DKen-DevCat/matrix-rc/docs/plan-phase1a.md

# Phase 1-a 計画（2026-10-25）

Phase 1-a（設計書①）のうち、ソフトの作成とあわせて行った購入先の調査の結果と、注文前に決めてほしいことをまとめる。決まったら Notion の部品表を更新し、このファイルの「決めてほしいこと」に結論を書き込む。

## 決めてほしいこと

| # | 項目 | 選択肢 | 推奨と理由 |
|---|---|---|---|
| 1 | **XIAO ESP32S3 Sense の買い先** | (a) スイッチサイエンスの再入荷を待つ（2,724円＋送料650円）<br>(b) Amazon で今すぐ買う（4,580円。出品ページに技適の記載なし）<br>(c) 秋月の再入荷を待つ（2,660円） | **(a)**。1,206円安く、販売店が技適の表示を保証している。待つ間もパソコン側の作業はシミュレータ（`firmware/sim`）で進められる。(b) にするなら、届いた本体で技適マークを確かめ、なければ Wi-Fi を使わない |
| 2 | **ジャンプ用の高減速モーター** | (a) Hailege N20 6V 15rpm（1,600円。減速比の記載なし、1000:1 前後と推定）<br>(b) Pololu 1000:1 HPCB 6V（7,112円、在庫1） | **(a)**。1-a ではカムが1回転してスイッチが反応するかを見るだけなので、減速比が多少違っても困らない。1-b2 でトルクが足りなければ (b) にする |
| 3 | **車台（タミヤ ユニバーサルプレートがどこも在庫切れ）** | (a) 入荷を待つ（タミヤ公式 396円＋送料510円）<br>(b) 100円ショップのプラ板か MDF 板に穴を開けて代わりにする | **(b)**。机上試作なので形は何でもよく、待つ理由がない |
| 4 | **ジャンプ用の MOSFET とダイオードの置き換え**（AO3400・SS14 は面実装でブレッドボードに挿せない） | (a) IRLU3410PBF と 1N5819（どちらもリード部品、秋月）に置き換える<br>(b) 面実装品を変換基板にはんだ付けする | **(a) で決定（2026-10-27）**。配線もピンも変わらない。3.3V で駆動したときのオン抵抗は未確認だが、流れるのは数百 mA なので足りる見込み。Notion の部品表、W1 システム構成図、W2 配線図を IRLU3410／1N5819 に直した。名刺サイズの C2（1-b3）は面実装の AO3400／SS14 のまま |
| 5 | **電源スイッチの定格**（小型スライドスイッチは 0.5A まで） | (a) 1-a はこのまま使う<br>(b) 定格の大きいスイッチにする | **(a)**。机上ではモーターが止められたときの電流に注意すればよい。名刺サイズにまとめる 1-b3 で見直す |
| 6 | **PlatformIO の導入**（実機へ書き込むのに必要。ネットワークから入れる） | (a) 今入れて、実機用ファームウェアのビルドを確認する<br>(b) XIAO が届いてから入れる | **(a)**。ビルドが通るかを部品が届く前に確かめておける（今は仮のヘッダで文法を確かめただけ） |
| 7 | **1-b1 の LTE 回線をどう用意するか**（技適済み Cat.1 bis モジュール EG800AK-JP・SIM7672JP は、どちらも個人向けの通販が見つからない） | (a) 代理店へ問い合わせて評価ボードかモジュールを入手し、機体に載せる<br>(b) 会場側にモバイルルーターを置き、機体は Wi-Fi のまま<br>(c) 中古スマホを機体に載せる | **(a) で決定（2026-10-25）**。会場のインフラの制約で会場側に機器を置けないため、機体で通信させる。(b) は却下。(c) はスマホだけで 110〜135g と機体目標（約 100g）の 2 倍を超えるので却下。進め方は下の「LTE を機体に載せる進め方」。**最初の行動は メカトラックス MicroCat.1U（SIM7672JP 搭載・技適取得済み・13,500円税別）の購入**。代理店への問い合わせは、MicroCat.1U で足りないと分かったときの保険に格下げ |

以前からの未決事項（Phase 1-a の注文には影響しない）：ジャンプの前進距離の対策（ばね軸の前傾か走行モーターの高速化か。1-b2 で決める）、ジオフェンスを条件付きで止めるか警告だけにするか、ペア運用の操作の形（2人で協力か1人で切り替えか）。

## 配線で気をつけること（調査でわかったもの）

- DRV8833 基板（Kitronik 5108）は nSLEEP 端子を High にしないとモーターが回らない。3.3V につなぐ
- WS2812B モジュールの電源は 3.5〜5.3V。3.3V ではなく電池から取る
- リポの JST コネクタは赤黒の向きがメーカーによって違う。つなぐ前にテスターで赤が＋であることを確かめる

---

## 購入計画（調査結果）

- 調査日: 2026-10-25（価格・在庫はこの日に各店の商品ページで確認したもの）
- 表記: **確認済み** = 商品ページで税込価格と在庫を確認した。**推定** = ページに記載がなく推測した。**未確定** = 在庫切れなどで今は買えない。
- 実際の購入、カート操作、問い合わせはしていない。

### 最初に読むこと（予定どおりに買えない3点）

1. **XIAO ESP32S3 Sense は国内の電子部品店ではどこも売り切れ。** スイッチサイエンス（8969）は「売り切れ・在庫数0」、秋月（118079）は「入荷未定」。今すぐ買えるのは Amazon（4,580円・Amazon 発送）だけで、出品ページには技適の記載がない（後述）。
2. **タミヤのユニバーサルプレートはどこも在庫切れ。** 秋月（109100）は入荷未定、Amazon（タミヤ 70098、販売元 Amazon.co.jp）は一時的な在庫切れ、タミヤ公式ショップは 70098・70157・70172 すべて在庫なし。総額には入れていない。
3. **AO3400 と SS14 は面実装部品で、ブレッドボードに直接挿せない。** また AO3400 は秋月で扱っていない。代わりに、挿して使えるリード部品の IRLU3410PBF（ロジックレベル N-ch）と 1N5819（SS14 と同じ 40V 1A のショットキー）を選んだ。

---

### 店ごとの購入表

#### A. 秋月電子通商（送料: 佐川 550円・ヤマト 600円、税込 11,000円以上は無料）

URL は `https://akizukidenshi.com/catalog/g/g<通販コード>/`

**部品**

| # | 部品 | 商品名 | 通販コード | 数量 | 単価(税込) | 小計 | 在庫 | 確認 |
|---|---|---|---|---|---|---|---|---|
| 5 | N-ch MOSFET（AO3400の代わり） | NchパワーMOSFET 100V17A IRLU3410PBF（リード部品 TO-251） | [106025](https://akizukidenshi.com/catalog/g/g106025/) | 1 | 100 | 100 | 在庫あり(953) | 確認済み |
| 5 | ショットキー（SS14の代わり） | ショットキーバリアダイオード 40V1A 1N5819（10本入） | [117244](https://akizukidenshi.com/catalog/g/g117244/) | 1袋 | 100 | 100 | 在庫あり | 確認済み |
| 5 | 抵抗 100Ω | カーボン抵抗 1/4W 100Ω（100本入） | [125101](https://akizukidenshi.com/catalog/g/g125101/) | 1袋 | 200 | 200 | 在庫あり | 確認済み |
| 5 | 抵抗 100kΩ（3本使う） | カーボン抵抗 1/4W 100kΩ（100本入） | [125104](https://akizukidenshi.com/catalog/g/g125104/) | 1袋 | 200 | 200 | 在庫あり | 確認済み |
| 5 | 抵抗 330Ω | カーボン抵抗 1/4W 330Ω（100本入） | [125331](https://akizukidenshi.com/catalog/g/g125331/) | 1袋 | 200 | 200 | 在庫あり | 確認済み |
| 6 | マイクロスイッチ（レバー付き） | マイクロスイッチ SS-10GL13（オムロン、ヒンジレバー、19.8×6.4mm） | [114659](https://akizukidenshi.com/catalog/g/g114659/) | 1 | 180 | 180 | 在庫あり(319) | 確認済み |
| 7 | WS2812B 1灯モジュール | WS2812B搭載シリアル制御フルカラーLEDモジュール AE-WS2812B | [108414](https://akizukidenshi.com/catalog/g/g108414/) | 1 | 70 | 70 | 在庫あり(263) | 確認済み |
| 10 | 小型スライドスイッチ | 基板用スライドスイッチ SS-12D00-G5（50VDC/0.5A、2.5mmピッチ） | [108790](https://akizukidenshi.com/catalog/g/g108790/) | 1 | 20 | 20 | 在庫あり | 確認済み |
| 11 | 電解コンデンサ 100µF/16V | 電解コンデンサー 100µF16V105℃ ルビコンPX | [110271](https://akizukidenshi.com/catalog/g/g110271/) | 2 | 10 | 20 | 在庫あり | 確認済み |
| 11 | 積層セラミック 0.1µF（3個使う） | 積層セラミックコンデンサー 0.1µF50V X7R 2.54mm（10個入） | [113582](https://akizukidenshi.com/catalog/g/g113582/) | 1袋 | 100 | 100 | 在庫あり | 確認済み |
| 12 | ボールキャスター | ボールキャスター（2セット入り、タミヤ製、高さ11〜35mm） | [110372](https://akizukidenshi.com/catalog/g/g110372/) | 1 | 330 | 330 | **残り5パック** | 確認済み |
| 13 | ブレッドボード | ブレッドボード EIC-801（電源ライン付き、84×54mm） | [100315](https://akizukidenshi.com/catalog/g/g100315/) | 1 | 450 | 450 | 在庫あり | 確認済み |
| 13 | ジャンパーワイヤ オス-オス | ジャンパーワイヤセット（60本以上・長さ混在） | [130088](https://akizukidenshi.com/catalog/g/g130088/) | 1 | 300 | 300 | 在庫あり | 確認済み |
| 13 | ジャンパーワイヤ オス-メス | ジャンパーワイヤ（オス-メス）15cm 青 10本 | [108934](https://akizukidenshi.com/catalog/g/g108934/) | 1 | 220 | 220 | 在庫あり | 確認済み |
| 14 | ピンヘッダー（DRV8833 基板用） | ピンヘッダー 1×40（2.54mm） | [100167](https://akizukidenshi.com/catalog/g/g100167/) | 1 | 35 | 35 | 在庫あり | 確認済み |
| | **部品の小計** | | | | | **2,525** | | |

**道具・消耗品**

| # | 品目 | 商品名 | 通販コード | 数量 | 単価(税込) | 小計 | 在庫 | 確認 |
|---|---|---|---|---|---|---|---|---|
| 14 | 温調はんだごて | 白光 はんだごて FX600-02（温度ダイヤル 200〜500℃） | [114456](https://akizukidenshi.com/catalog/g/g114456/) | 1 | 5,200 | 5,200 | 在庫あり(65) | 確認済み |
| 14 | こて台 | はんだこて台 ST-11（スポンジ付き） | [102537](https://akizukidenshi.com/catalog/g/g102537/) | 1 | 940 | 940 | 在庫あり | 確認済み |
| 14 | はんだ | はんだ 0.8mm（Sn60/Pb40 鉛入り・ヤニ入り） | [118341](https://akizukidenshi.com/catalog/g/g118341/) | 1 | 500 | 500 | 在庫あり | 確認済み |
| 14 | テスター | デジタルマルチメーター MAS-838（導通ブザー付き、10A レンジあり） | [100198](https://akizukidenshi.com/catalog/g/g100198/) | 1 | 2,780 | 2,780 | 在庫あり(18) | 確認済み |
| 14 | データ通信用 USB-C ケーブル | USBケーブル USB2.0 Type-C⇔Type-C 0.5m（通信用） | [117018](https://akizukidenshi.com/catalog/g/g117018/) | 1 | 130 | 130 | 在庫あり | 確認済み |
| 14 | 熱収縮チューブ | スミチューブC クリア Φ3×1m | [108636](https://akizukidenshi.com/catalog/g/g108636/) | 1 | 50 | 50 | 在庫あり | 確認済み |
| 14 | 熱収縮チューブ | スミチューブC 黒 Φ1.5×1m | [106788](https://akizukidenshi.com/catalog/g/g106788/) | 1 | 40 | 40 | 在庫あり | 確認済み |
| 14 | はんだ吸取線 | はんだ吸取線 CP-2015 | [115260](https://akizukidenshi.com/catalog/g/g115260/) | 1 | 210 | 210 | 在庫あり | 確認済み |
| | **道具の小計** | | | | | **9,850** | | |

- **部品だけ買う場合**: 2,525円＋送料 550円（佐川）＝ **3,075円**
- **道具も一緒に買う場合**: 12,375円（11,000円以上なので送料無料）＝ **12,375円**

#### B. スイッチサイエンス（掲載商品はすべて送料区分200: 商品代金 3,000円以上で送料無料、未満は 200円）

URL は `https://www.switch-science.com/products/<SKU>`

| # | 部品 | 商品名 | SKU | 数量 | 単価(税込) | 小計 | 在庫 | 確認 |
|---|---|---|---|---|---|---|---|---|
| 4 | DRV8833 ブレイクアウト | DRV8833搭載モータドライバ基板 10.8V 1.5A（Kitronik 5108、38×28mm） | [8880](https://www.switch-science.com/products/8880) | 1 | 1,298 | 1,298 | **在庫数3** | 確認済み |
| 2 | 走行用ホイール | Pololu ペアホイール 32×7mm 白（3mm D軸用、2個入り） | [1786](https://www.switch-science.com/products/1786) | 1 | 812 | 812 | 在庫25 | 確認済み |
| 12 | N20 取付ブラケット | 超小型メタルギアドモーター用ブラケット（2個入、Pololu 989、10×12mm ギアボックス用、#2 ネジとナット付き） | [9069](https://www.switch-science.com/products/9069) | 2 | 539 | 1,078 | 在庫21 | 確認済み |
| | **小計** | | | | | **3,188** | | |
| | 送料 | 3,000円以上なので無料 | | | | **0** | | 確認済み |

- 第一候補だった [XIAO ESP32S3 Sense（8969）](https://www.switch-science.com/products/8969) は 2,724円（税込）だが**売り切れ（在庫数0、入荷通知の登録のみ可能）**。この商品は送料区分650。
- ブラケットは4個になる（走行用2個＋高減速用1個＋予備1個）。高減速モーターを車体に固定しないなら1袋（539円）でよい。その場合の小計は 2,649円で、3,000円を下回るので送料 200円がかかる。

#### C. Amazon.co.jp（下の5品はすべて「出荷元 Amazon」）

URL は `https://www.amazon.co.jp/dp/<ASIN>`

| # | 部品 | 商品名 | ASIN | 数量 | 価格(税込) | 販売元 | 在庫・お届け予定 | 確認 |
|---|---|---|---|---|---|---|---|---|
| 1 | XIAO ESP32S3 Sense | Seeed Studio XIAO ESP32S3 センス（**ピンヘッダーはんだ付け済み版**） | [B0DRNW6KMG](https://www.amazon.co.jp/dp/B0DRNW6KMG) | 1 | 4,580 | Leverage- | 在庫あり | 確認済み（技適の記載はページにない） |
| 2 | N20 6V 300rpm ×2 | CHANCS N20 DC 6V 300RPM（2個入り、3mm D軸・軸長10mm） | [B0CD1T22QG](https://www.amazon.co.jp/dp/B0CD1T22QG) | 1 | 2,199 | chancs | 残り4点・10/27 着 | 確認済み |
| 3 | N20 高減速 | Hailege N20 6V 15RPM（2個入り、3mm×10mm 軸） | [B0DMW1ZFB3](https://www.amazon.co.jp/dp/B0DMW1ZFB3) | 1 | 1,600 | Hailege JP | 残り20点・10/27 着 | 価格は確認済み。**減速比はページになく、1:1000前後と推定** |
| 9 | 1S リポ 保護回路付き JST-PH | EEMB LP603449-PCM 3.7V 1100mAh（PCM 内蔵、JST-PHR-02 2mmピッチ、34.5×51×6.3mm） | [B08FD39Y5R](https://www.amazon.co.jp/dp/B08FD39Y5R) | 1 | 999 | A2Battery（メーカー直販） | 在庫あり・10/27 着 | 確認済み |
| 8 | JST-PH 2ピン ピグテール | MKBKLLJY JST-PH 2.0 オス・メス ケーブル 15ペア（22AWG 100mm、熱収縮チューブ付き） | [B0CX12NJV9](https://www.amazon.co.jp/dp/B0CX12NJV9) | 1 | 679 | MKBKLLJY | 在庫あり・10/27 着 | 確認済み |
| | **小計** | | | | **10,057** | | | |
| | 送料 | 各ページの表示は「無料配送」 | | | **0** | | | 「初回注文特典」で無料と出ている商品がある。Amazon 発送品は合計 3,500円以上なら通常も無料のはずだが、これは**推定** |

- リポを2本にする場合は +999円。
- XIAO のピンヘッダー**はんだ付けなし版**は [B0C69FFVHH](https://www.amazon.co.jp/dp/B0C69FFVHH)。同じ 4,580円で、販売元も同じ Leverage-（確認済み）。

---

### 合計

| | 秋月 | スイッチサイエンス | Amazon | **合計** |
|---|---|---|---|---|
| **部品のみ**（送料込み） | 2,525＋送料550 ＝ 3,075 | 3,188＋送料0 ＝ 3,188 | 10,057＋送料0 ＝ 10,057 | **16,320円** |
| **部品＋道具**（送料込み） | 12,375＋送料0 ＝ 12,375 | 3,188 | 10,057 | **25,620円** |

- ユニバーサルプレートは在庫がないため含めていない。入荷すればタミヤ公式で 396円（＋送料 510円、5,000円以上は無料）。
- 秋月の部品を佐川ではなくヤマトで送る場合、部品のみの合計は +50円。

#### 選び方で合計が変わるところ

| 変更 | 合計への影響 |
|---|---|
| 高減速モーターを **Pololu 1000:1 HPCB 6V**（スイッチサイエンス [6255](https://www.switch-science.com/products/6255)、7,112円、**在庫1**、減速比が明記されている）にする | +5,512円（Hailege の 1,600円が不要になる） |
| XIAO をスイッチサイエンスの再入荷を待って買う（2,724円＋区分650の送料 650円。小計が 8,000円未満のため） | Amazon 経由より **-1,206円**。技適の表示も販売店が保証している |
| XIAO をカメラなしの **XIAO ESP32S3**（秋月 [118078](https://akizukidenshi.com/catalog/g/g118078/) 1,480円・在庫あり／スイッチサイエンス [8968](https://www.switch-science.com/products/8968) 1,456円・在庫あり）にして、カメラは後で考える | 秋月で買う場合は -3,100円。ただしカメラとマイクがなくなる |
| 走行用ホイールを **FEETECH Dシャフト用ホイール 60mm**（スイッチサイエンス [7494](https://www.switch-science.com/products/7494)、1個110円、在庫4）×2 にする | -592円。直径が大きいので速くなり、キャスターの高さも変わる |

#### 店ごとの代わりの候補（すべて確認済み）

- MOSFET を面実装で揃えたい場合: 秋月 MTN2306AN3（[117513](https://akizukidenshi.com/catalog/g/g117513/)、10個 120円）＋ SOT23変換基板（[103659](https://akizukidenshi.com/catalog/g/g103659/)、30円）。変換基板へのはんだ付けが必要。
- SS14 そのものが欲しい場合: 秋月 [113240](https://akizukidenshi.com/catalog/g/g113240/)（20個 150円、面実装）。
- 純正 JST の PH ポスト: 秋月 B2B-PH-K-S（[112802](https://akizukidenshi.com/catalog/g/g112802/)、10円）。電池の PHR-02 と確実に嵌合する。
- DRV8833 の代わりに秋月だけで済ませる場合: DRV8835使用DCモータードライブキット（[110346](https://akizukidenshi.com/catalog/g/g110346/)、600円、在庫あり）。自分ではんだ付けするキット。

---

### 技適（無線部品）

- **XIAO ESP32S3／ESP32S3 Sense**: 工事設計認証番号 **217-230892**（秋月の商品ページの記載）。スイッチサイエンスのページには「技適マークの表示された製品です。商品写真は古いロットでマークがないが、現物には表示されている」とある。
- **Amazon で買う場合**: 出品ページに技適の記載はない。Seeed の正規品なら同じ認証の対象と考えられるが、これは**推定**。届いたら本体のシールドかラベルで技適マークを確認し、マークがなければ電波を出さない（Wi-Fi/BLE を使わない）こと。確実にしたいなら、スイッチサイエンスか秋月の再入荷を待つ。
- ほかの部品に送信機能を持つものはない。

---

### 初心者が迷いやすい点

**XIAO ESP32S3 Sense**
- スイッチサイエンス版と Amazon B0C69FFVHH には 7ピンのヘッダーが2本付いてくるが、はんだ付けはされていない。ブレッドボードに挿すには自分ではんだ付けする。Amazon B0DRNW6KMG ははんだ付け済み。
- XIAO に電池用のコネクタはない。裏面の **BAT+／BAT− パッド**に線をはんだ付けし、その先にピグテールを付ける。
- USB-C からの充電電流は 100mA（スイッチサイエンスの仕様）。1100mAh の電池だと満充電まで約11時間以上かかる（推定）。
- XIAO の BAT 入力は 4.2V（仕様）。1S リポ以外はつながない。

**リポ電池と極性**
- JST-PH の赤黒の向きは、メーカー間で統一されていない。EEMB のページにも「使用前に機器とコネクタの極性を確認」とある。はんだ付けや接続の前に、必ずテスターで電池の赤＝＋を確かめ、XIAO の BAT+ へ赤がつながることを確認する。逆に挿すとショートや故障につながる。
- 電池側のコネクタは **PHR-02（ハウジング側）**。秋月の「コネクター付コード 2P(A)」（105679）やスイッチサイエンス 2215 も同じハウジング側なので、**電池とは嵌合しない**。電池と嵌合するのは、Amazon セットの「オス」側か、秋月 B2B-PH-K-S（ポスト）。
- Amazon の互換品「オス」は純正 JST ではない。固い・緩いことがある。
- EEMB のページには保護回路（PCM）、UL1642、IEC62133-2 の記載があるが、**PSE の記載はない**。保管と充電は耐火のリポバッグなどで行うのが安全。

**N20 モーター**
- **「1000RPM」と「1000:1」は別物。** Amazon には「1000RPM（毎分回転数）」と書かれた高速モーターが多い。今回の高減速は「低 rpm（6V で 15〜30rpm 程度）」を選ぶ。走行用の 300rpm と取り違えないよう、届いたらラベルで確認する。
- Hailege 6V 15RPM のページには減速比が書かれていない。別の出品の仕様表（6V 300RPM＝1:50）から逆算して 1:1000 前後と推定した。比率を保証したいなら Pololu 1000:1（6255）を選ぶ。
- 6V 定格のモーターを 1S（3.7〜4.2V）で回すので、無負荷回転は表示の6〜7割程度になる（推定。300rpm 品なら約180〜210rpm）。机上試験には十分。
- **走行用は 1-a では 300rpm のままでよい。** 2026-10-28 の物理演算で、真上に跳んで 3cm の段差を越えるには走行 0.5m/s 以上が要ると分かった（設計書② 7章・C4）。上の「1000RPM と 1000:1 は別物」の注意は、ジャンプ用（高減速）を買うときの話。
- **1-b の走行モーターは Pololu 136:1 Sub-Micro 遊星ギアモーター 6Dx19L（#2358）×2**（2026-10-29 決定。N20 1000rpm 級から変更）。長さ 19mm なので左右を一直線に並べられ、後輪を揃えられる（N20 は 24mm で並ばず、前後にずらすと段差越えのあと向きが変わる）。1-b2 の段差試験までに買う。注意：
  - 軸は 2mm の D カット。いま買った Pololu 32×7mm の車輪は 3mm 用なので、2mm→3mm のアダプタか、2mm 軸に合う車輪が要る
  - ギアは樹脂。段差で車輪が止められたときに歯が欠けないか、1-a の机上で先に 1 個試す
  - 6V 定格を 1S で回すので、ファームは速度の上限を 1.0 にした設定（`pio run -e xiao_1b`）で書き込む
- 軸は 3mm の D カット、長さ10mm。Pololu 32×7mm ホイールと FEETECH ホイールはどちらも 3mm D 軸用で適合する。
- Pololu 989 ブラケットは 10×12mm のギアボックス部を挟む形。汎用の N20 も同じ断面なので取り付けられる。ただし減速比でギアボックスの長さが変わるので、挟む位置を合わせる。
- 汎用の N20 は端子がむき出しのものが多い。リード線をはんだ付けし、モーター端子間に 0.1µF を付けるとノイズ対策になる。

**DRV8833（Kitronik 5108）**
- 同梱品は基板1枚だけで、ピンヘッダーは付いていない（販売店ページの同梱内容から判断）。秋月のピンヘッダーを切ってはんだ付けする。
- 38×28mm と大きいので、ミニブレッドボードではなく EIC-801 にした。
- **nSLEEP 端子を High にしないとモーターが動かない**（DRV8833 の nSLEEP は内部でプルダウンされている）。GPIO で制御するか 3.3V につなぐ。
- 電源 Vcc は 2.7〜10.8V（仕様）なので、1S リポを直接つなげる。在庫が3個しかない点にも注意。

**MOSFET とダイオード（高減速モーターのローサイドスイッチ）**
- IRLU3410PBF は「IRL」系のロジックレベル品で、ピンのピッチは 2.29mm（秋月の仕様）。ブレッドボードには少しピンを広げて挿す。3.3V 駆動時のオン抵抗はデータシートで確認すること（ここでは確認していない）。
- 1N5819 はモーターと逆向き（並列）に入れるフライバックダイオード。帯のある側をモーターの＋側（電源側）に向ける。

**スライドスイッチ**
- 小型スライドスイッチは定格 0.5A が上限（SS-12D00-G5）。電池の主電源をこれで切り替えると、モーター2個の起動電流やロック時の電流には余裕がない。机上試作では問題になりにくいが、本番では定格の大きいスイッチを使うか、XIAO の電源だけを切るなど構成を見直すこと。

**WS2812B**
- 秋月のモジュールは電源電圧 3.5〜5.3V（仕様）。**3.3V ではなく電池（3.7〜4.2V）から給電**する。データ線には 330Ω を直列に入れる。

**その他**
- マイクロスイッチ SS-10GL13 の端子はラグ形で、ブレッドボードには挿せない。リード線をはんだ付けする。
- タミヤのボールキャスターは高さを 11〜35mm で調整できる。32mm ホイールなら車軸の高さは約16mm なので、組み立て後に車体が水平になる高さに合わせる。
- はんだは初心者が扱いやすい鉛入り（Sn60/Pb40）にした。換気し、作業後は手を洗う。鉛フリーにするなら秋月 [129524](https://akizukidenshi.com/catalog/g/g129524/)（520円）。
- USB-C ケーブルは Mac につなぐ前提で C-C にした。USB-A ポートにつなぐなら秋月 [117017](https://akizukidenshi.com/catalog/g/g117017/)（A-C 0.5m、100円）。
- ニッパーとワイヤーストリッパーは対象外として計上していない。持っていなければ別途必要。
- ユニバーサルプレートの代わりは、入荷を待つか、100円ショップのプラ板や MDF 板に穴を開けて使う。

---

### 参考: 部品表 B の LTE Cat.1 bis 評価ボード

| 候補 | 調査結果 | 結論 |
|---|---|---|
| Quectel EG800AK-JP | Quectel が 2026年4月のプレスリリースで技適（TELEC）取得を発表（[Quectel](https://www.quectel.com/news-and-pr/telec-certified-cat-1-bis-module-japan-it-week-spring-2026/)）。[SoftBank の IoT カタログ](https://www.softbank.jp/business/service/iot/module/pdf/cidna-eg800ak-jp-catalog.pdf)にも掲載がある。個人が通販で買える評価ボードは、スイッチサイエンス、秋月、検索結果のどこにも見つからなかった | **代理店への問い合わせが必要** |
| SIMCom SIM7672JP | [NTT](https://www.ntt.com/business/iot/product/m284.html) と [SoftBank](https://www.softbank.jp/business/service/iot/module/pdf/cidna-sim7672jp-catalog.pdf) の法人 IoT ページにモジュールの IOT 完了の記載がある。見つかった評価キットは欧州向けの SIM7672E/G 用だけで、JP 版の個人向け販売は見つからなかった | モジュール単体は代理店。**ただし下の MicroCat.1U に載っている** |
| **メカトラックス MicroCat.1U**（SIM7672JP 搭載） | [製品ページ](https://mechatrax.com/products/microcat1/)、[1U の発売案内](https://mechatrax.com/2026/08/04/microcat1u-release/)、[公式ストア](https://store.mechatrax.com/)。RP2350B＋SIM7672JP、U.FL＋技適取得済みアンテナ付属、13,500円（税別）、個人購入可 | **1-b1 はこれで進める**（決めてほしいこと 7） |

- 方針どおり、LILYGO SIM7672G/SIM7670G は技適がないため候補にしていない。
- スイッチサイエンスで個人が買える技適済み LTE 製品には Cat-M や Wio LTE などがあるが、Cat.1 bis ではないので対象外。Cat-M（LTE-M）は上りが数百 kbps で、QVGA の MJPEG（9fps で 400〜700kbps）には足りない。

#### 入手先の候補（2026-10-25 に検索で確認。購入前に各ページで再確認する）

「個人が買える技適済みの Cat.1 bis」は、検索で確認できた範囲では **メカトラックスの MicroCat.1／1U だけ**だった。Google の AI 回答が挙げた他の経路は、確認すると条件が付く。

| 候補 | 中身 | 技適 | 個人購入 | 判定 |
|---|---|---|---|---|
| **メカトラックス MicroCat.1U** | RP2350B（Raspberry Pi Pico 2 互換ピン）＋ **SIM7672JP**（部品表 B と同じモジュール）。U.FL コネクタと技適取得済みの 4G アンテナが付属。nanoSIM。2026-08-04 発売、13,500円（税別） | 基板として JATE/TELEC 取得済み（公式の記載） | 公式ストアで可 | **本命**。1-b1 はこれで始める |
| メカトラックス MicroCat.1 | 上と同じでアンテナが基板上。2026-06-30 発売、13,500円（税別） | 同上 | 可 | アンテナを筐体内で動かせないので 1U を選ぶ |
| LILYGO T-SIM7670G-S3／TUOPUONE ESP32-S3 SIM7670G | ESP32-S3＋SIM7670G（海外版 Cat.1 bis）。6,000〜8,000円 | **モジュールの設計**には工事設計認証 201-230743（SIMCom、2025-08-13、MRA 経由）がある。ただし Amazon／AliExpress で買う個々の基板のモジュールに**技適マークが表示されているか**、付属アンテナが認証条件に合うかは確認できない。LILYGO が認証書を公開している機種にこの型が含まれるかも未確認 | 可 | **使わない**（CLAUDE.md の方針どおり。マークの表示と認証条件のアンテナを販売元が証明できれば再検討） |
| Quectel EG800AK-JP／EG915Q-JP（Mouser・DigiKey） | 生モジュールか評価ボード | モジュールに JATE/TELEC | DigiKey で見つかるのは **北米・欧州版（-NA／-EU）だけ**で、-JP の在庫は確認できなかった | 入手経路として当てにしない |
| Quectel EG915Q-JP 評価キット（加賀デバイス） | UMTS&LTE EVB KIT JP／mini PCIe EVB KIT JP。国内適合アンテナ付き | モジュールに JATE/TELEC、docomo／KDDI の IOT 完了 | 見積り（個人可否・価格は不明） | 保険。MicroCat.1U で足りないとき |
| SIMCom SIM7672JP 評価ボード（キャセイ・トライテック／ザイン・モバイルテック） | 評価ボード | JATE/TELEC、docomo IOT 完了 | 見積り。SIM7672JP 用 EVB の型番は公開ページに見つからない | 保険 |

**MicroCat.1U を選ぶ理由**：(1) 設計書②で選んでいた SIM7672JP そのもの（B1/B3/B8/B18/B19/B26/B28、上り 5Mbps）。(2) 基板単位で技適が取れていて、アンテナも認証条件のものが付属するので、1-b3 で「自作基板＋アンテナ設計」をしなくてよくなる可能性が高い。(3) Pico 2 互換なら基板は 21×51mm 級（寸法は未確認）で、名刺サイズの下段に XIAO と並べて置ける見込み。

**MicroCat.1U で確認すること（買う前にメカトラックスへ聞くか、資料で見る）**

- SIM7672JP の UART が Pico 互換ヘッダに直接出ているか。出ていなければ RP2350B に「UART の素通し」ファームを入れて XIAO の D6/D7 とつなぐ（MicroPython で数十行）
- 電源：1S リポ（3.4〜4.2V）を VSYS に入れて SIM7672JP まで動くか。送信バースト時の電流と、基板上に入っているコンデンサ
- 基板の寸法・重さ、SIM7672JP の UART の最大速度（PPP の帯域上限になる）
- 技適マークの表示場所（基板のシール）

#### LTE を機体に載せる進め方（決めてほしいこと 7 の決定を受けて）

難しさは段階で分かれる。1-b1 は「ソフトが主で、手を動かす部分は配線だけ」。1-b3 は、MicroCat.1U がそのまま載るなら「配置と筐体」、載らないなら「基板を作ってはんだ付けする」で、後者が本当の山。どちらも AI が肩代わりできる部分と、できない部分をはっきり分けておく。

| 段階 | やること | 難しさ | AI が肩代わりできる | 自分で手を動かす |
|---|---|---|---|---|
| 入手 | メカトラックス公式ストアで MicroCat.1U を 1 枚買う（上の表）。代理店への問い合わせは保険 | **低**（見つかった） | 購入前の確認事項の整理、資料（SIM7672 の AT コマンド集・メカトラックスの資料）の読み込み | 購入・SIM の契約 |
| 1-b1 | MicroCat.1U を 1-b1 用の大きめの台車に載せ、XIAO の D6/D7（UART）でつなぐ（必要なら RP2350B を UART の素通しにする）。機体→VPS の UDP と DTLS-PSK を通す | **中**。配線は UART 2 本＋電源＋GND。ファームウェアが作業の大半 | ファームウェア全部（下の「ファームウェアの作り方」）、RP2350B の素通しファーム、電源の計算、AT コマンドの手順、ログの読み解き | 配線、SIM の挿入、電波の実測（床置きで RSSI／到達率） |
| 1-b3 | MicroCat.1U をそのまま名刺サイズの下段に収める。収まらないか電源が足りないときだけ、SIM7672JP（LCC＋LGA、17.6×15.7mm）を載せる小基板を自作する | そのまま載るなら **中**（配置・筐体・放熱）。自作基板なら **高**（下の 4 点） | KiCad の回路図・部品配置・配線の作成とチェック、設計ガイドとの照合、BOM、ステンシル付きの基板発注データ | 配置と筐体の工作。自作基板ならはんだ付け（ホットプレートかホットエアでのリフロー）、テスターでの確認、2〜3 回の基板の作り直し |

**「初めてのハード開発には重い」の中身**は、自作基板に進んだ場合の次の 4 点。いずれも「できない」ではなく「回数とお金がかかる」種類の難しさで、MicroCat.1U がそのまま載れば 1 と 3 はなくなる。

1. **実装**：モジュールは LCC（側面の端子）＋LGA（裏面の端子）で、手はんだでは裏面に届かない。ホットプレート（数千円）とステンシル（基板と一緒に発注、数百円）でリフローする。ホビーでは一般的な手順で、失敗しても部品代（モジュール 1 個数千円）で済む。モジュールは最初から 2 個買う
2. **電源**：送信時に 1〜2A のバーストが出る。XIAO の 3.3V からは取れないので、電池（3.4〜4.3V）からモジュールへ直結し、すぐそばに 100µF 以上を置く。電池が 3.5V を切ると送信のたびにモジュールが落ちる（設計書①の警告 3.5V はこのためにも効く）
3. **アンテナ**：基板上にアンテナを設計せず、モジュールのアンテナ端子から短い 50Ω の線で u.FL コネクタへ出し、技適の認証条件（利得の上限）に合う FPC アンテナを買って貼る。これで基板側の高周波設計をほぼなくせる。91mm の筐体でグランドが足りず効率が落ちる問題（レビュー A-5）は残るので、1-b1 の評価ボードで床置きの実測をしてから筐体内の置き場所を決める
4. **技適の守り方**：工事設計認証はモジュール単体に付く。モジュールを改造せず、認証条件の範囲のアンテナを使えば、自作基板に載せても問題ない。設計ガイドに書かれた条件（アンテナ利得・電源）から外れない

**ファームウェアの作り方（1-b1）**：モジュールの中の TCP/UDP を AT コマンドで操る方式ではなく、**PPP でつなぐ**。ESP-IDF の `esp_modem` が Quectel／SIMCom 系の AT 手順と PPP を持っていて、つながった後は Wi-Fi のときと同じ UDP ソケットと mbedTLS の DTLS がそのまま使える。`lib/core`（判断ロジック）はハードに依存しないのでそのまま。変わるのは「Wi-Fi の接続」が「モジュールの起動＋PPP」になる部分だけ。Arduino のまま進めるなら Arduino を ESP-IDF のコンポーネントとして組む形になるので、1-b1 では ESP-IDF に寄せるのが素直。

**帯域の現実**：UART の速さが上限になる。921,600bps なら PPP の後で実効 700kbps 程度。いまの機体は映像（QVGA 9fps で 400〜700kbps）＋音声（16kHz 16bit PCM で 256kbps）なので、音声は 8kHz か圧縮に、映像は 5fps 程度に落とす。モジュールが 2〜3Mbps の UART に対応していれば上げる。USB で結ぶ道（ESP-IDF の `esp_modem_usb_dte`）もあるが、XIAO の USB は書き込みにも使うので後回し。

**代理店に聞くこと**（MicroCat.1U で足りないときの保険。問い合わせの下書きに使う）

- 個人（または個人事業）への販売の可否と、最小数量
- EG800AK-JP／SIM7672JP の評価ボード（EVB キット）の型番・価格・納期。モジュール単体の価格・納期
- ハードウェア設計ガイド、AT コマンド集、工事設計認証の条件（対応アンテナと利得の上限）の入手方法
- UART の最大速度と、PPP での利用可否
- 国内キャリア（docomo／KDDI／SoftBank の MVNO データ SIM）での接続実績。IMEI 登録などの手続きが要るか
- 推奨するアンテナ（FPC タイプ）の型番

**SIM**：国内 MVNO のデータ専用 SIM（docomo 網のものが帯域の相性で無難。SIM7672JP は docomo の相互接続性試験が完了している）。基板が届く前に契約しない。

**1-b1 の完成条件に足すこと**：床置きでの RSSI と到達率、300ms 停止の回数、UART の速さごとの映像 fps。これが 1-b3 の筐体とアンテナの配置を決める材料になる。

---

### 確認元

- 秋月の送料: [ご利用ガイド](https://akizukidenshi.com/catalog/pages/buy.aspx)（佐川 550円／ヤマト 600円、税込 11,000円以上は無料）
- スイッチサイエンスの送料: [配送と送料](https://www.switch-science.com/policies/shipping-policy)（区分200: 3,000円以上無料／未満 200円。区分650: 8,000円以上無料／未満 650円）
- タミヤ公式の在庫: [70098](https://tamiyashop.jp/shop/g/g70098/)、[70157](https://tamiyashop.jp/shop/g/g70157/)、[70144](https://tamiyashop.jp/shop/g/g70144/)（いずれも在庫なし）
- 各商品の URL は表中のとおり。
