DKen-DevCat/matrix-rc/docs/drawings/c1.png

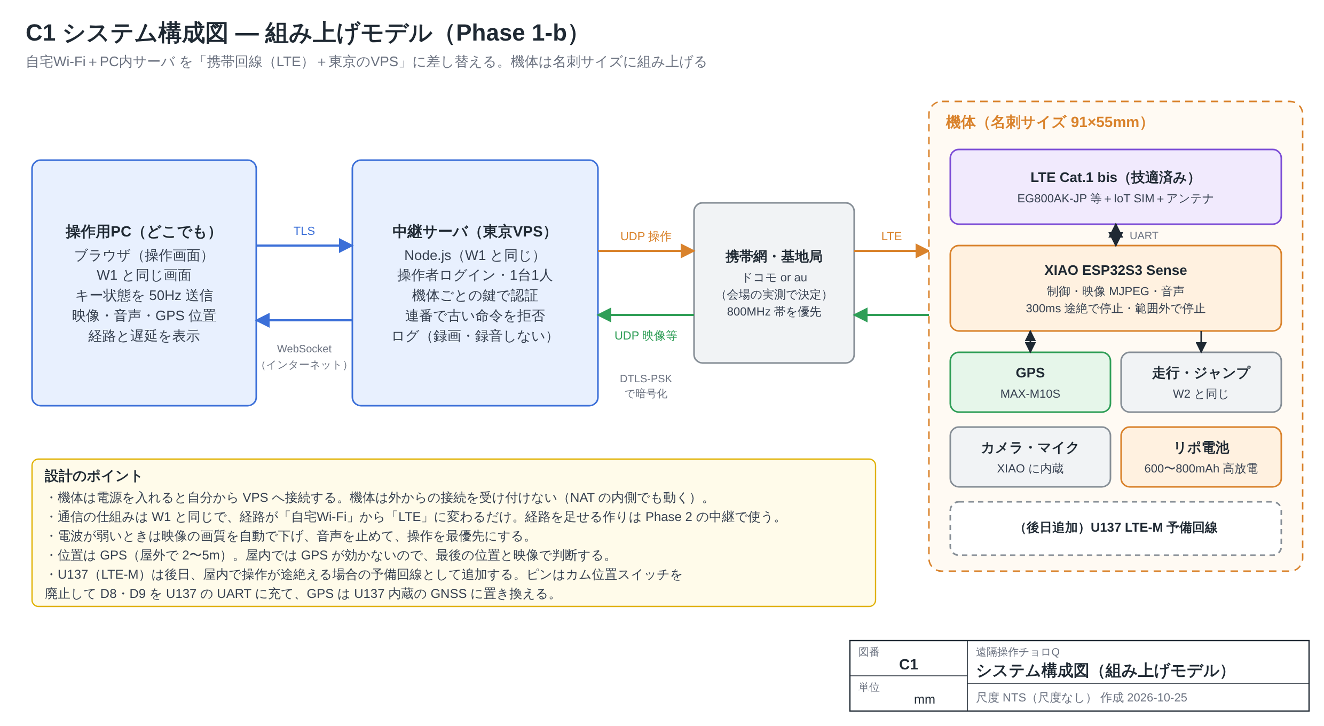
docs/drawings/c1.png
