DKen-DevCat/matrix-rc/docs/drawings/c2.png

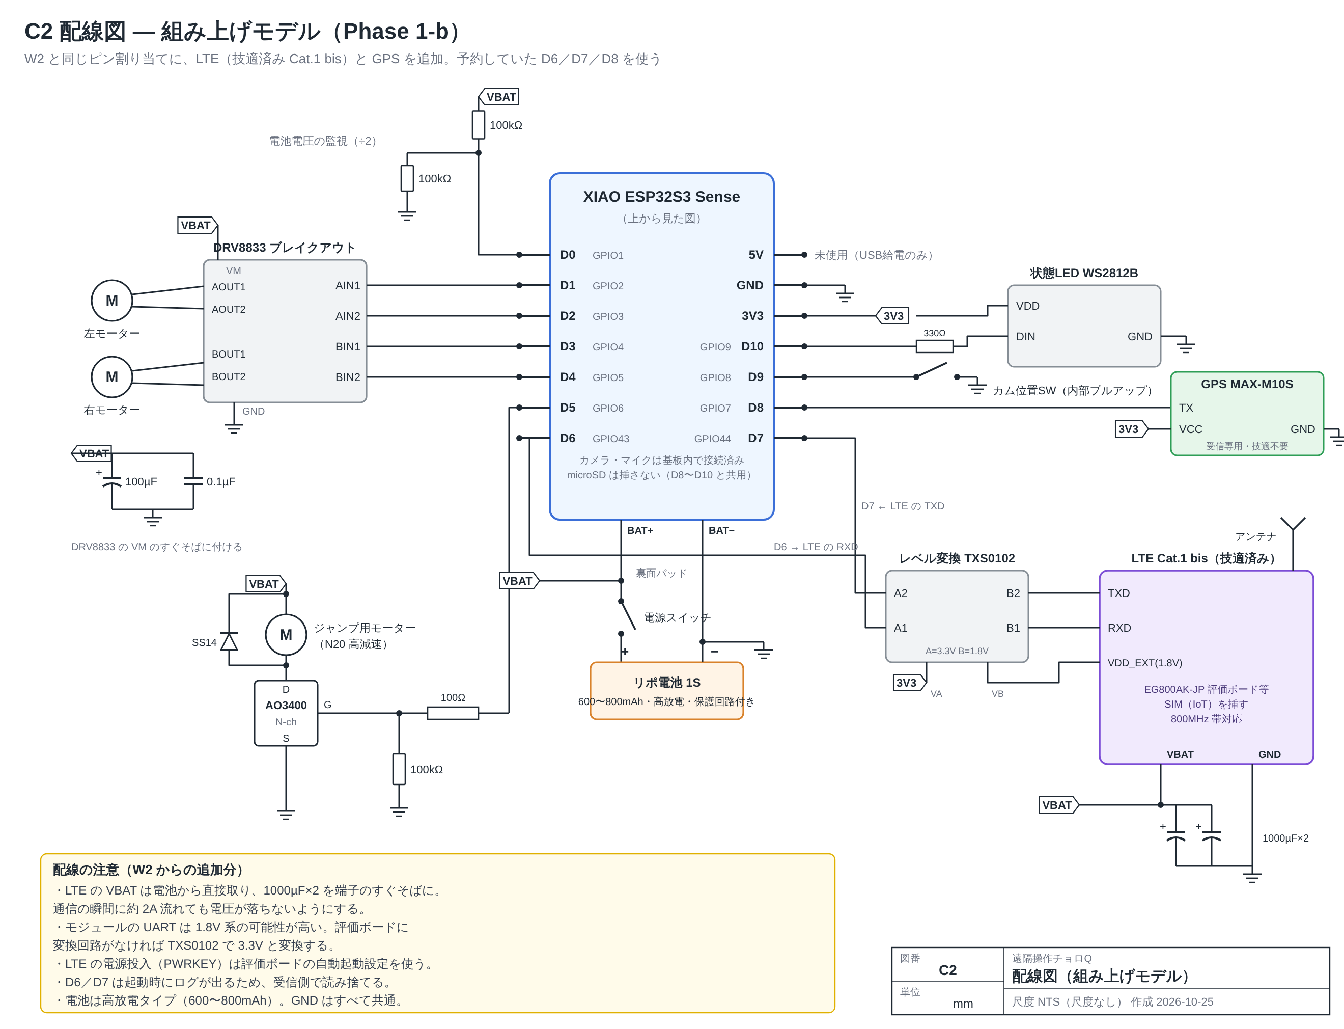
docs/drawings/c2.png
