DKen-DevCat/matrix-rc/docs/drawings/c3.png

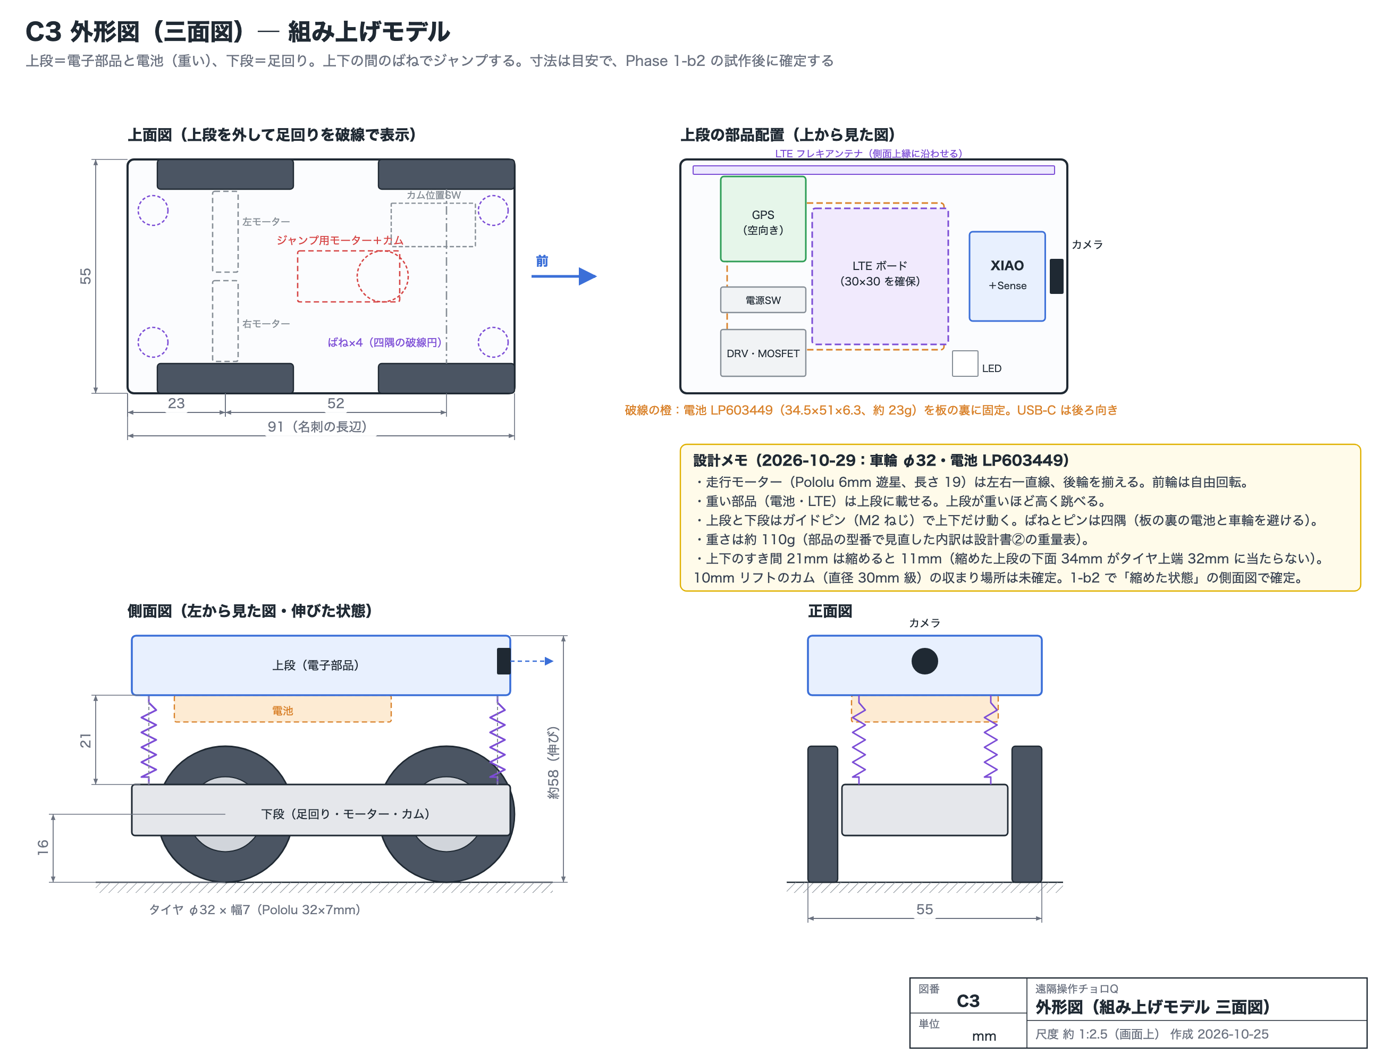
docs/drawings/c3.png
