DKen-DevCat/matrix-rc/docs/drawings/c4.png

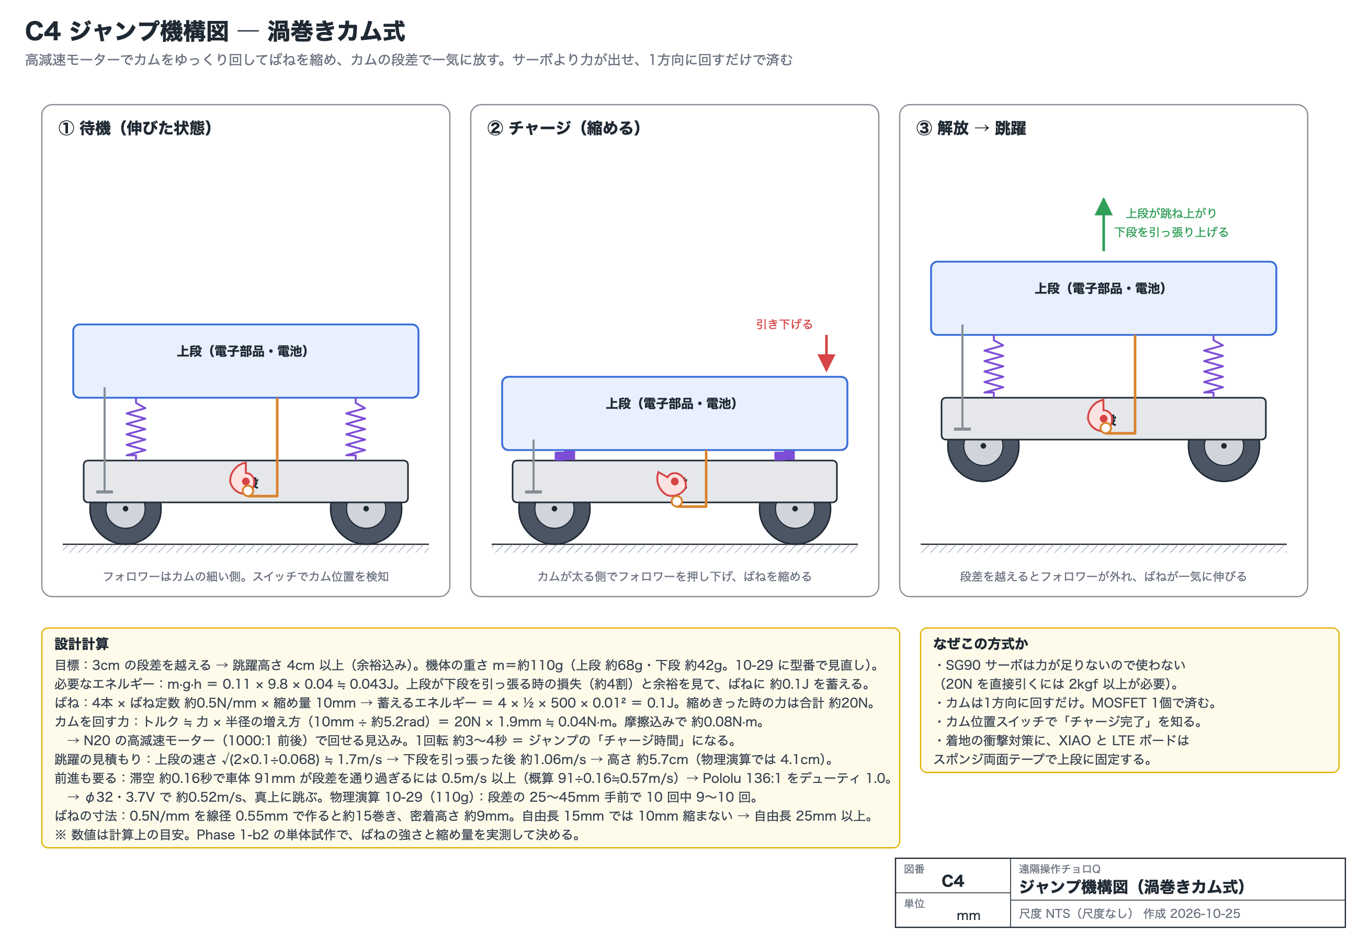
docs/drawings/c4.png
