DKen-DevCat/matrix-rc/docs/drawings/r1.png

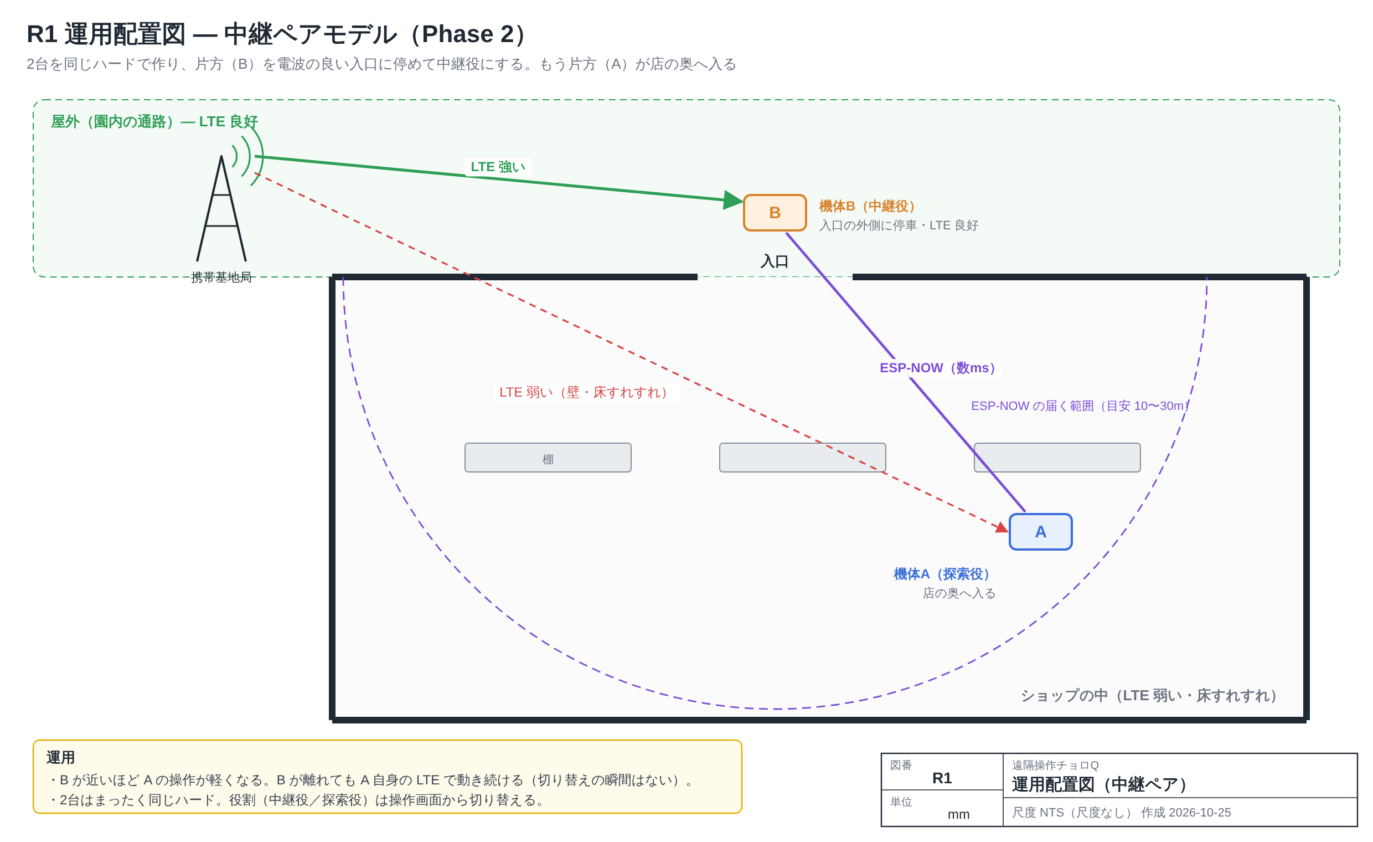
docs/drawings/r1.png
