DKen-DevCat/matrix-rc/docs/drawings/r2.png

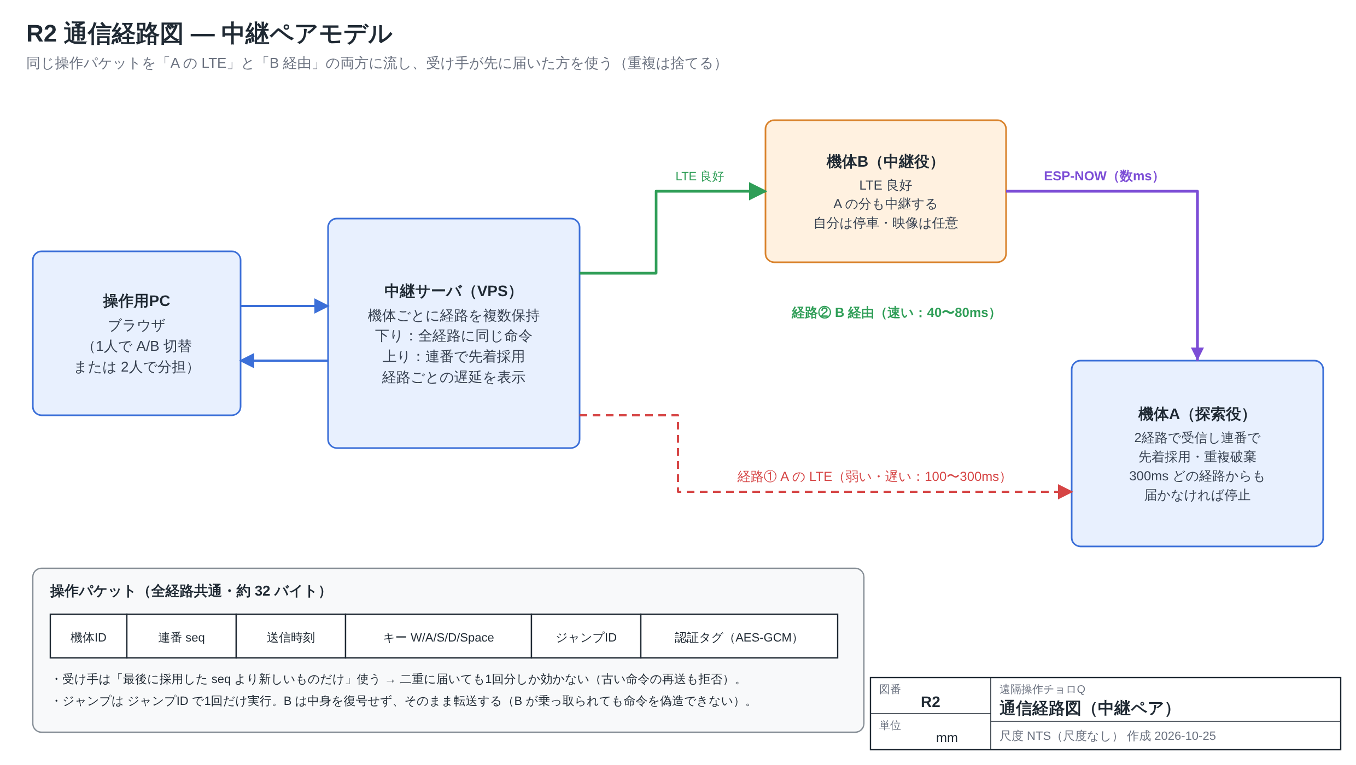
docs/drawings/r2.png
