DKen-DevCat/matrix-rc/docs/drawings/r3.png

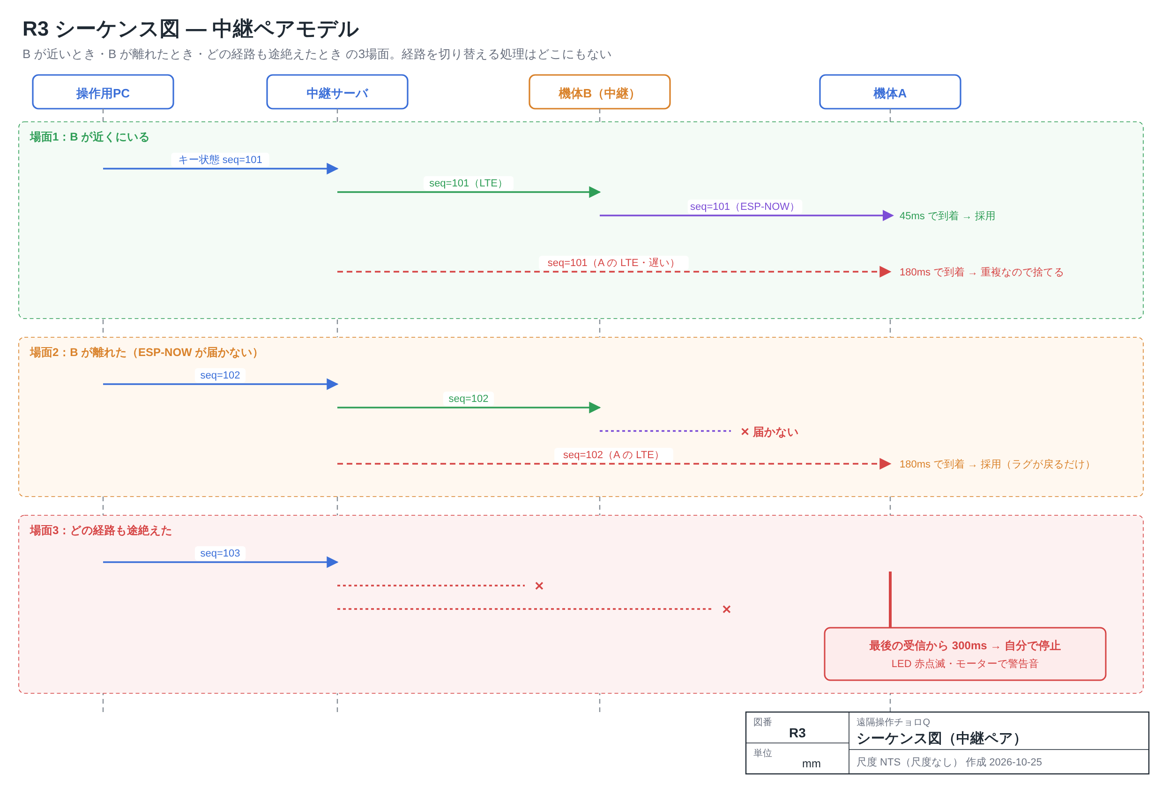
docs/drawings/r3.png
