DKen-DevCat/matrix-rc/docs/drawings/w1.png

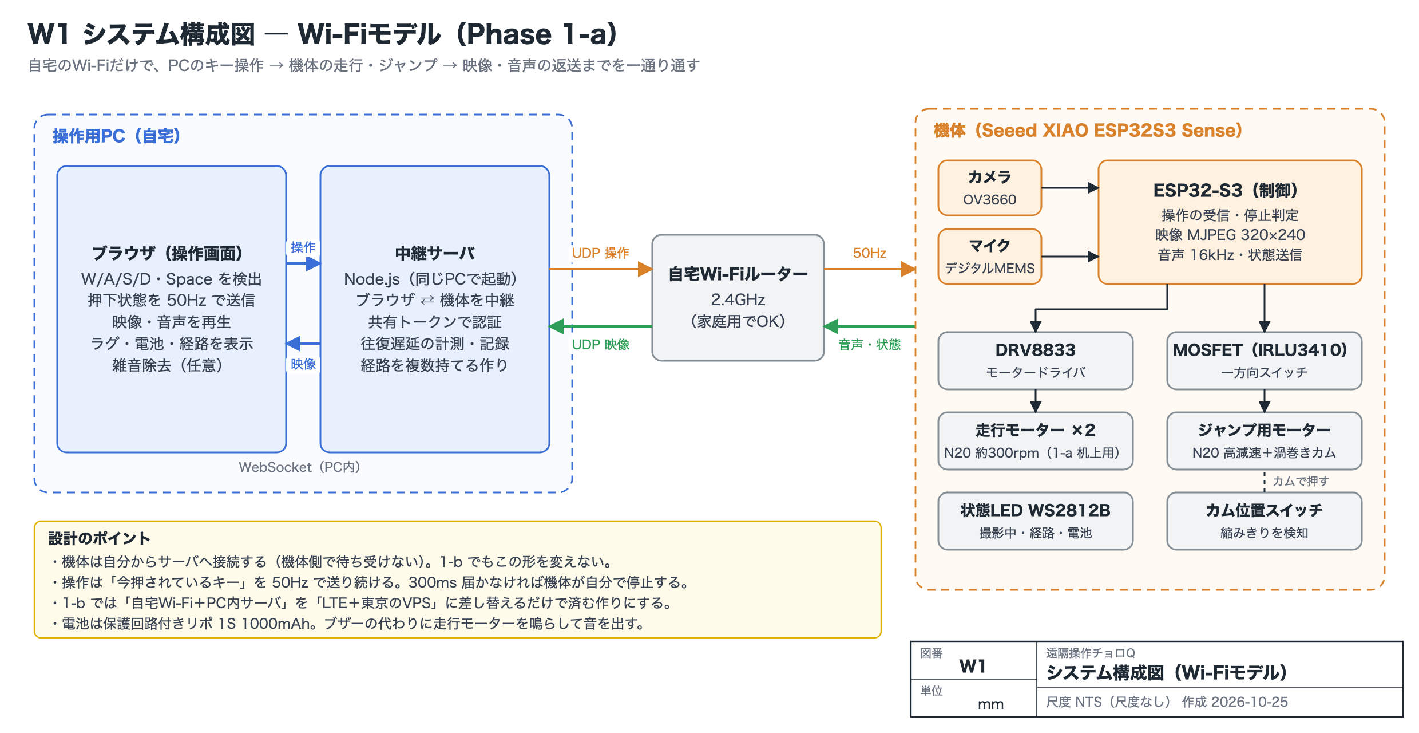
docs/drawings/w1.png
