DKen-DevCat/matrix-rc/docs/drawings/w2.png

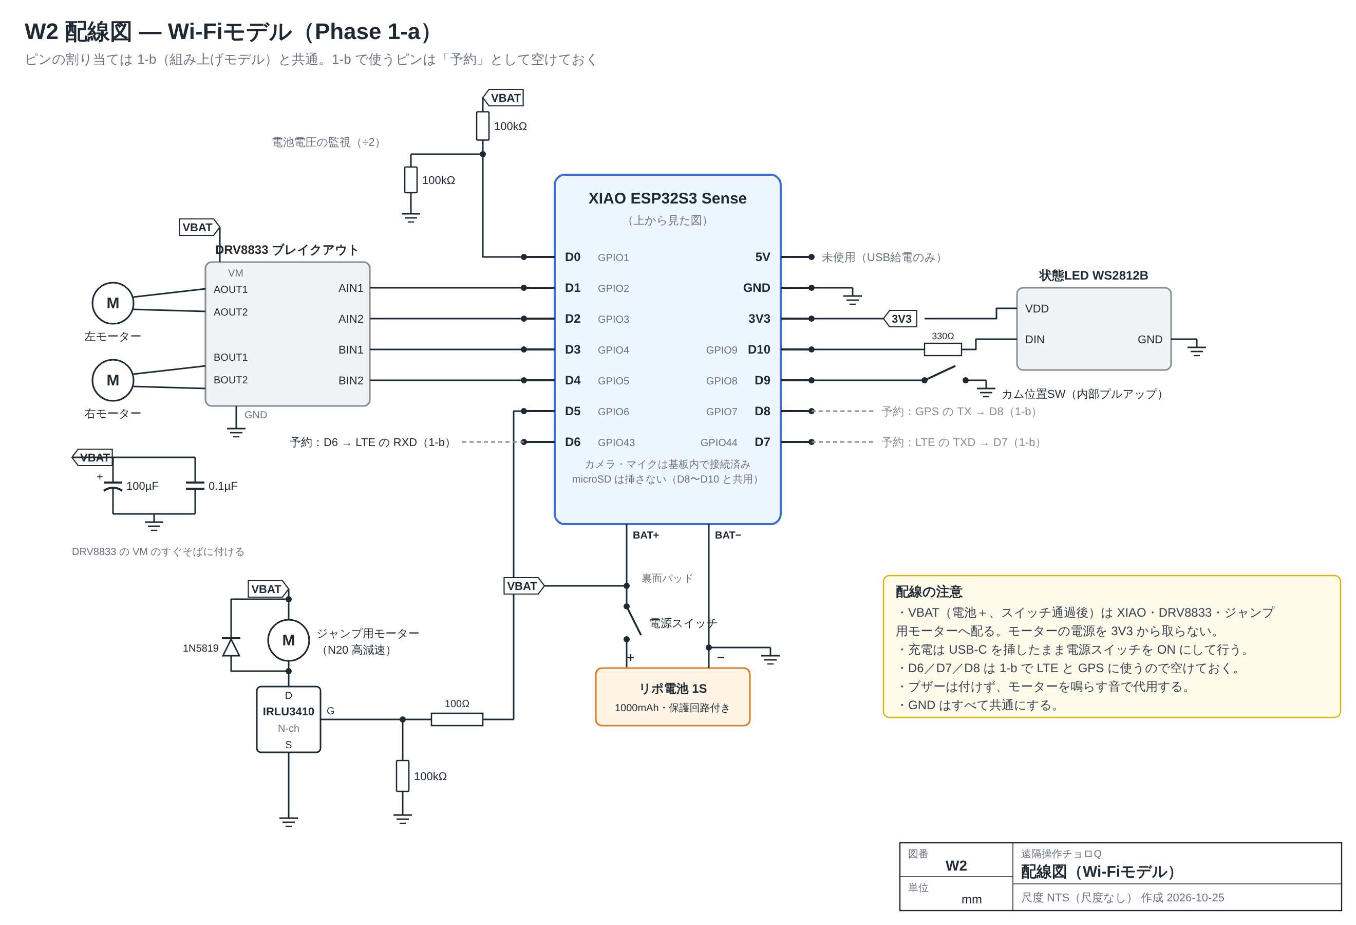
docs/drawings/w2.png
