DKen-DevCat/matrix-rc/docs/drawings/w3.png

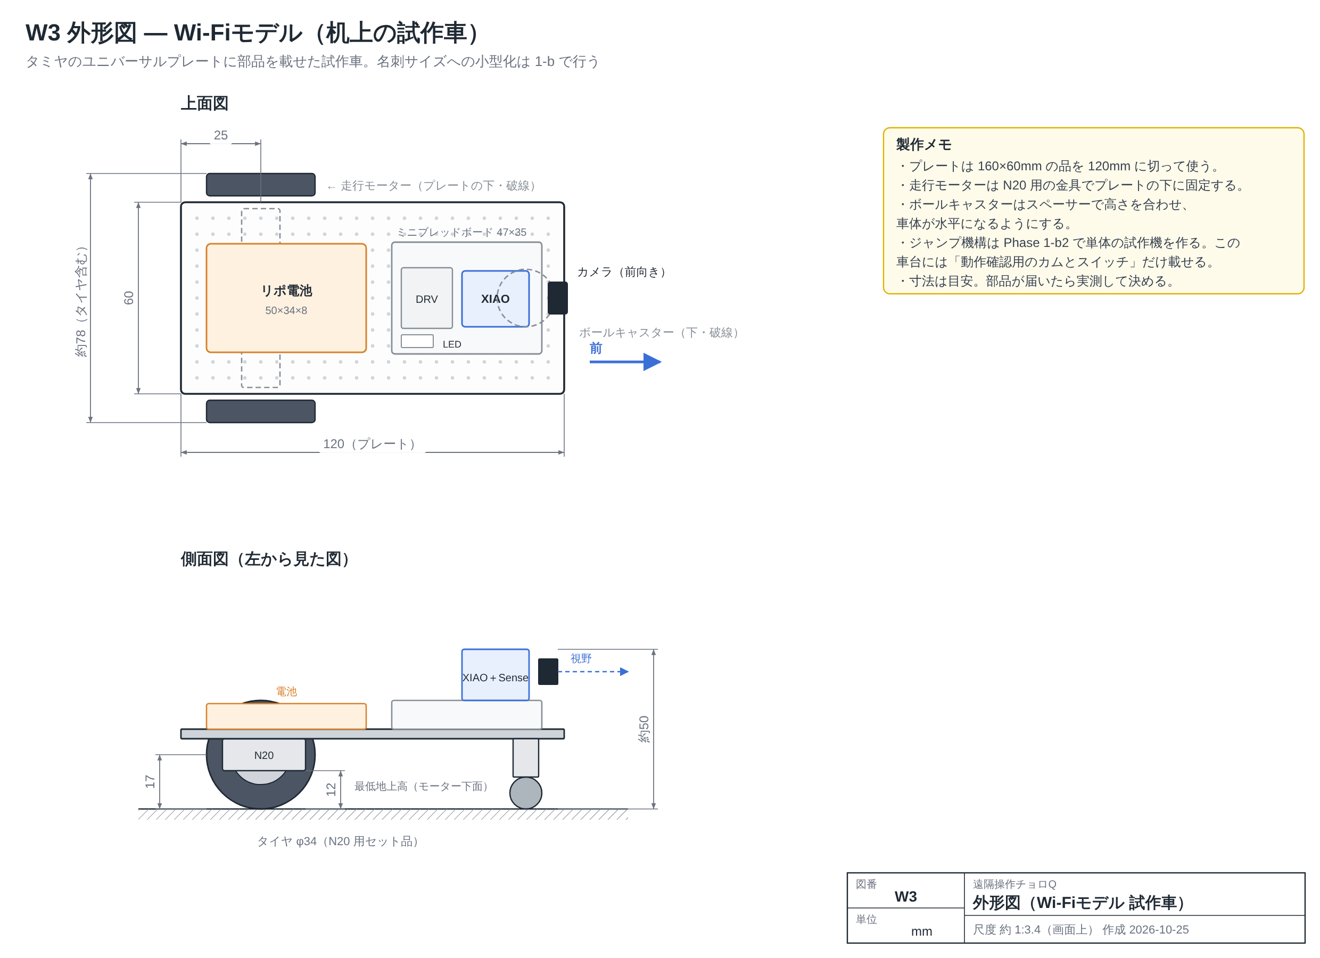
docs/drawings/w3.png
