DKen-DevCat/matrix-rc/docs/model/front.png

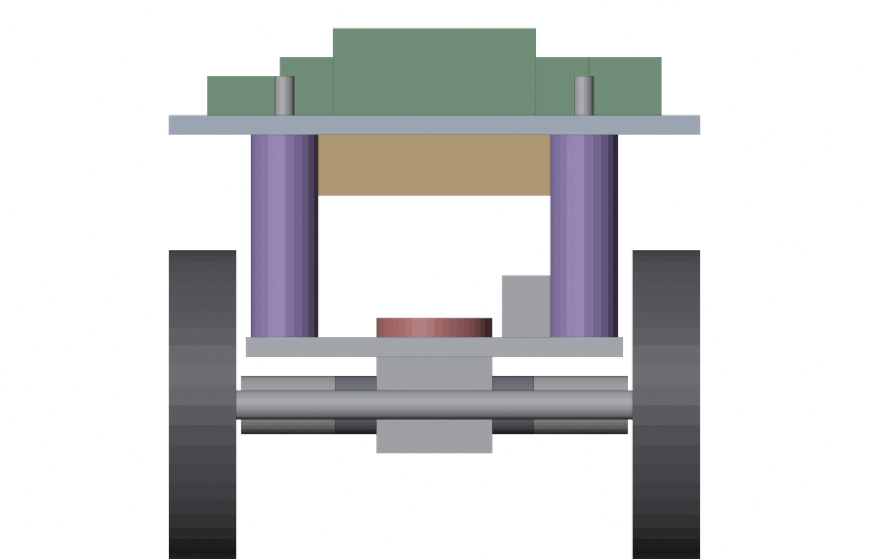
docs/model/front.png
