DKen-DevCat/matrix-rc/docs/model/iso.png

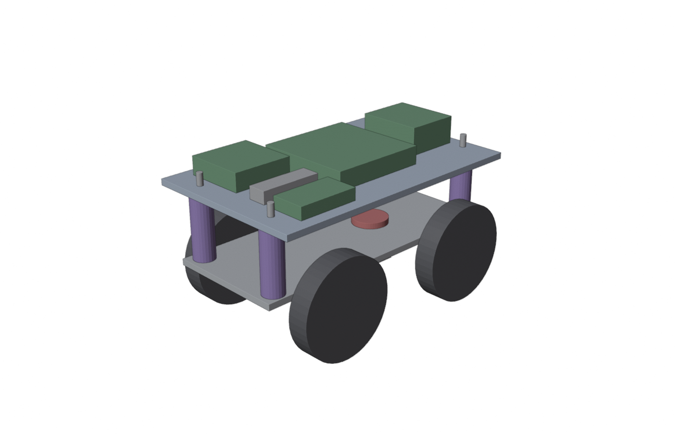
docs/model/iso.png
