DKen-DevCat/matrix-rc/docs/model/side.png

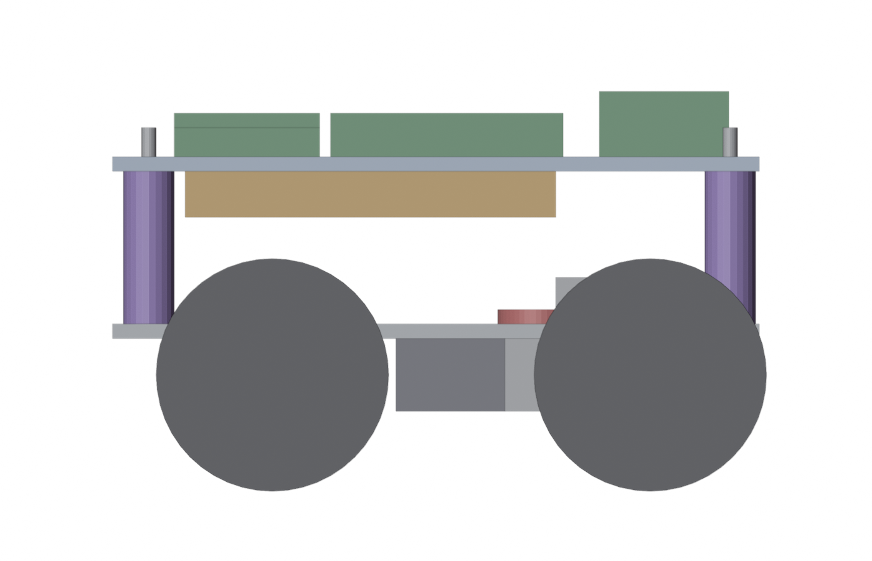
docs/model/side.png
