DKen-DevCat/matrix-rc/docs/model/side_compressed.png

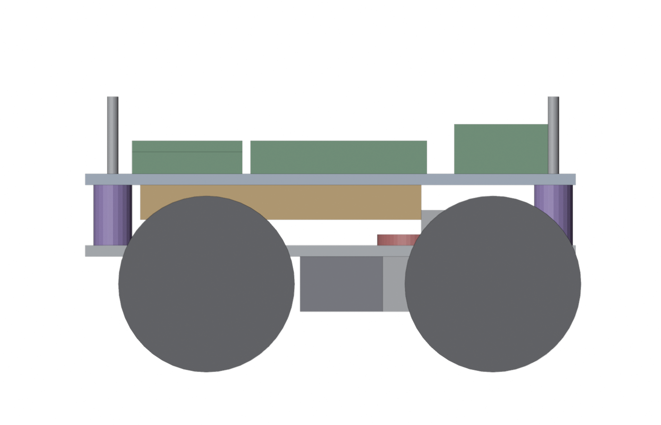
docs/model/side_compressed.png
