DKen-DevCat/matrix-rc/docs/model/top.png

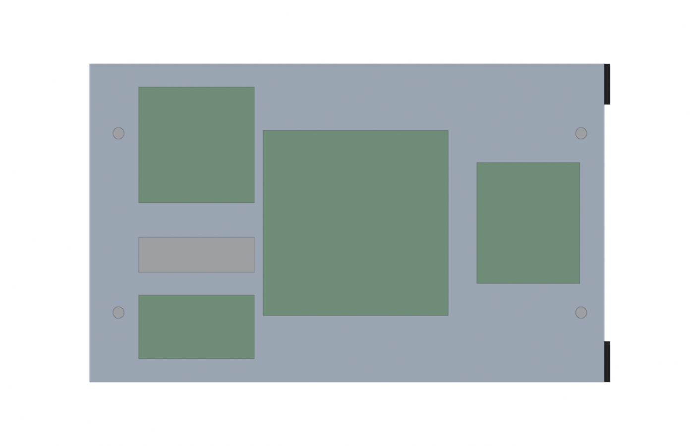
docs/model/top.png
