DKen-DevCat/matrix-rc/sim/fusion/sample/wheel_rl.stl

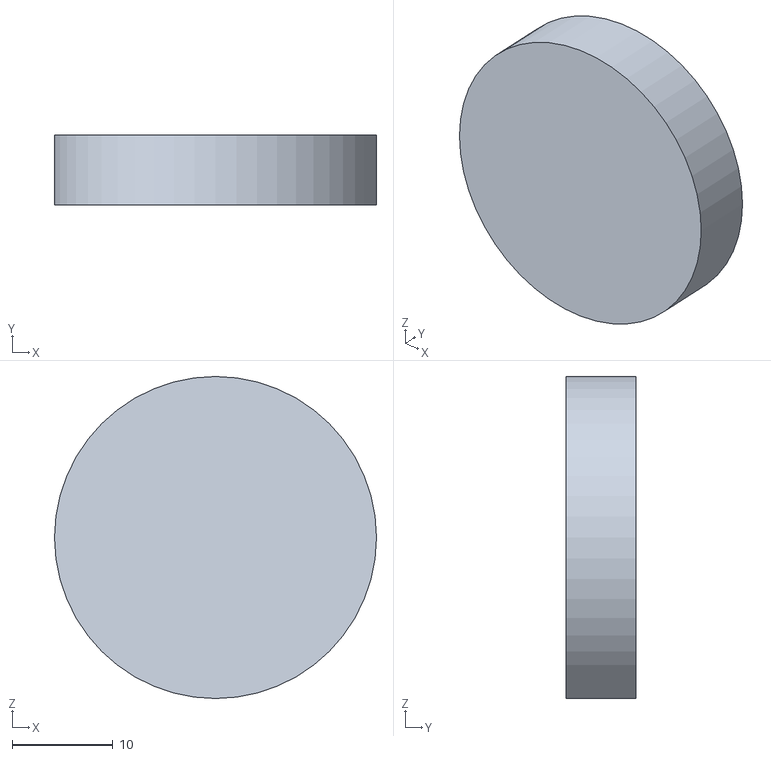
[picture p19: CAD file, 2026-10-29]
sim/fusion/sample/wheel_rl.stl
32.0 x 7.00 x 32.0
