DKen-DevCat/matrix-rc/sim/model/export/lower_motor_l_can.stl

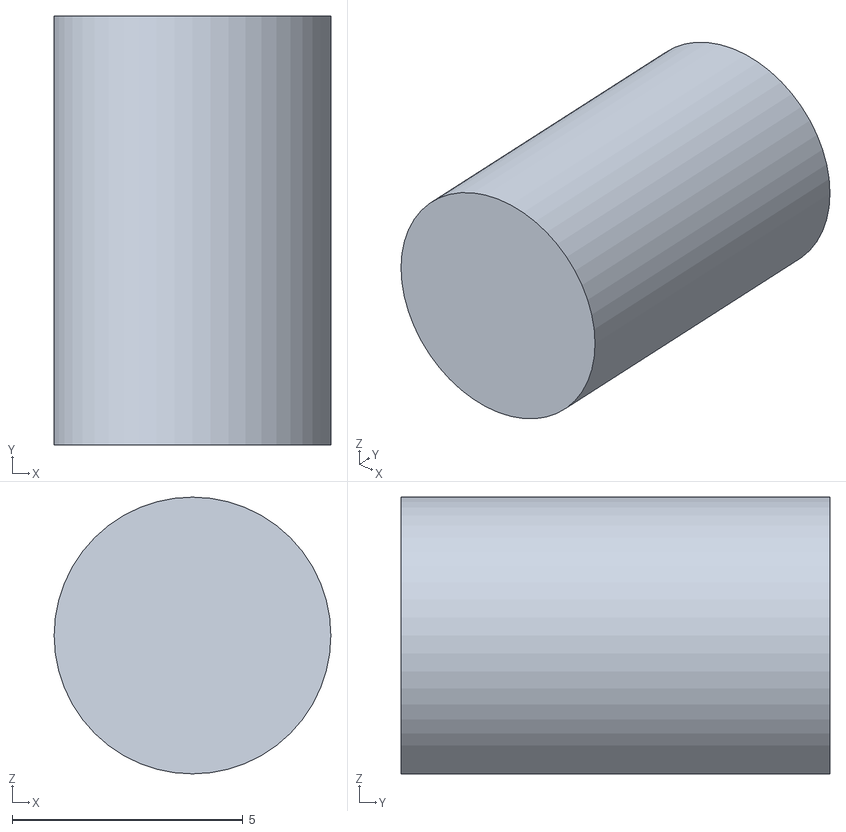
[picture p20: CAD file, 2026-10-29]
sim/model/export/lower_motor_l_can.stl
6.00 x 9.30 x 6.00
