DKen-DevCat/matrix-rc/sim/model/export/lower_motor_l_gear.stl

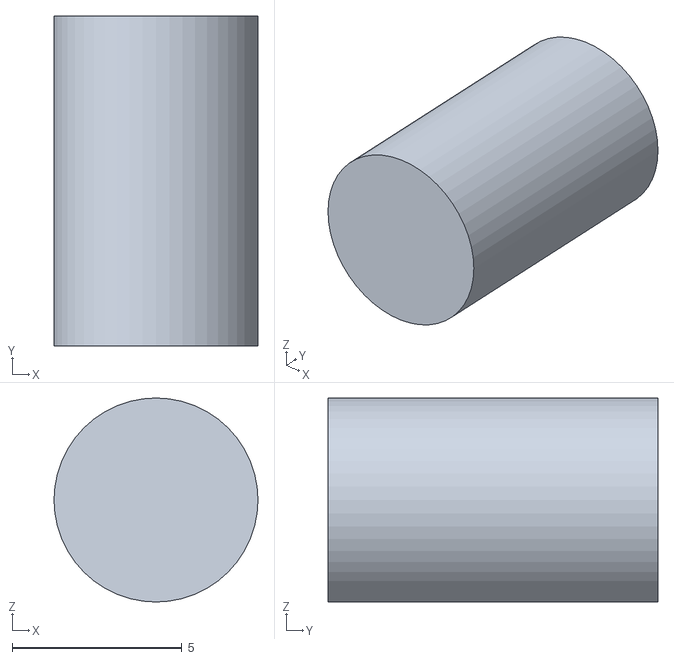
[picture p21: CAD file, 2026-10-29]
sim/model/export/lower_motor_l_gear.stl
6.00 x 9.70 x 6.00
