DKen-DevCat/matrix-rc/sim/fusion/sample/lower_deck.stl

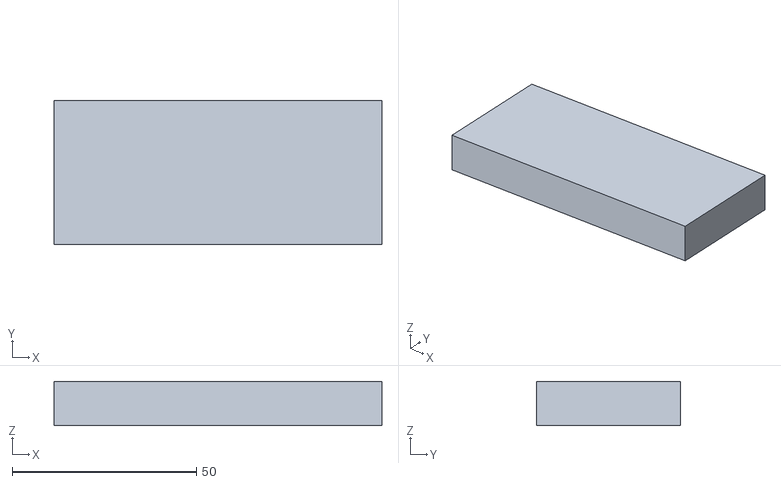
[picture p22: CAD file, 2026-10-29]
sim/fusion/sample/lower_deck.stl
89.0 x 39.0 x 12.0
