DKen-DevCat/matrix-rc/sim/fusion/sample/upper_deck.stl

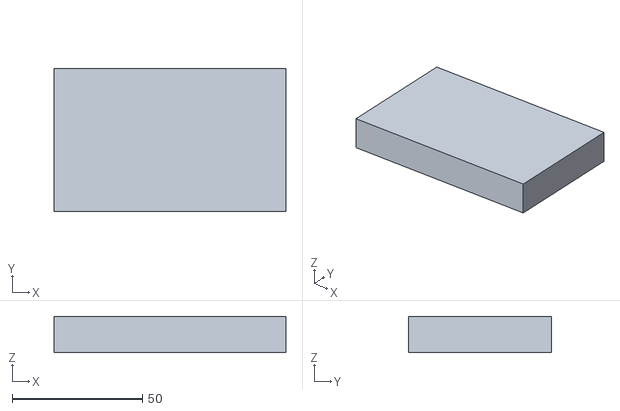
[picture p23: CAD file, 2026-10-29]
sim/fusion/sample/upper_deck.stl
89.0 x 55.0 x 14.0
