DKen-DevCat/matrix-rc/sim/model/export/upper_lte.stl

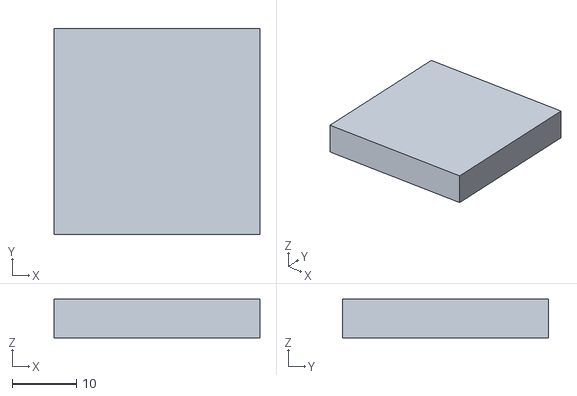
[picture p24: CAD file, 2026-10-29]
sim/model/export/upper_lte.stl
32.0 x 32.0 x 6.00
