DKen-DevCat/matrix-rc/sim/model/export/lower_axle_f.stl

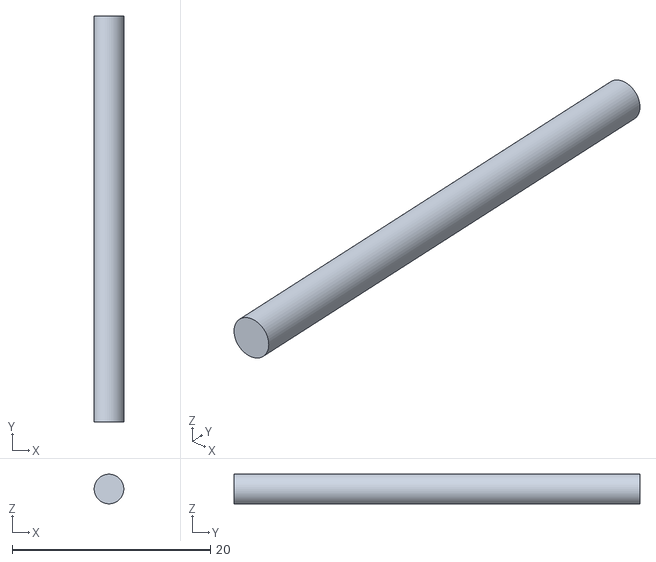
[picture p25: CAD file, 2026-10-29]
sim/model/export/lower_axle_f.stl
3.00 x 41.0 x 3.00
