DKen-DevCat/matrix-rc/sim/model/export/upper_battery.stl

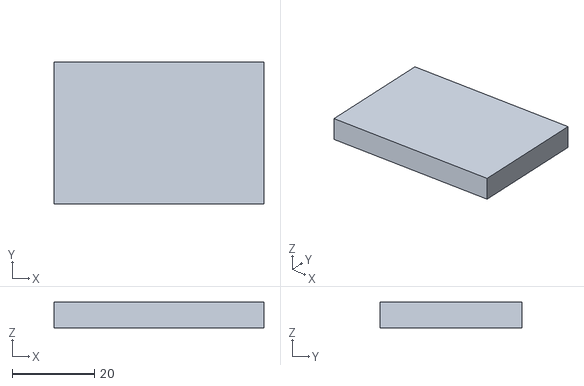
[picture p26: CAD file, 2026-10-29]
sim/model/export/upper_battery.stl
51.0 x 34.5 x 6.30
