DKen-DevCat/matrix-rc/sim/model/export/lower_cam_switch.stl

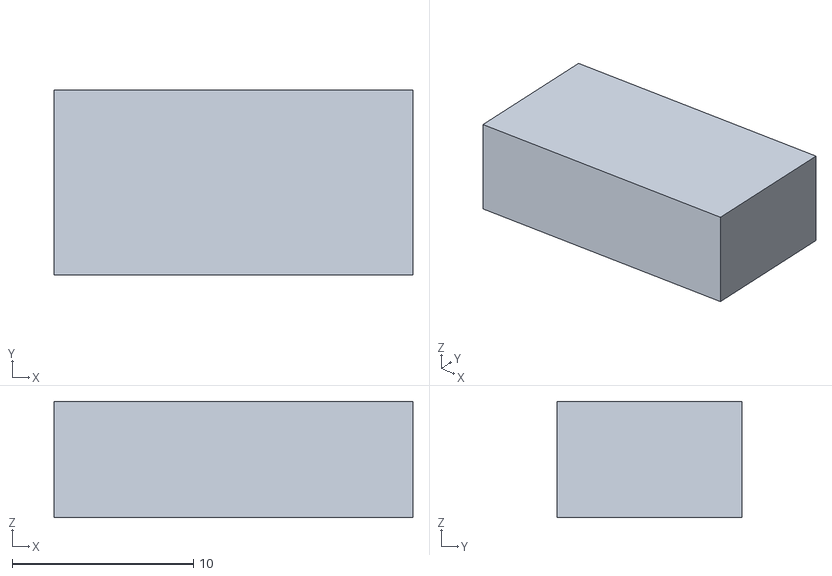
[picture p27: CAD file, 2026-10-29]
sim/model/export/lower_cam_switch.stl
19.8 x 10.2 x 6.40
