DKen-DevCat/matrix-rc/sim/model/export/upper_gps.stl

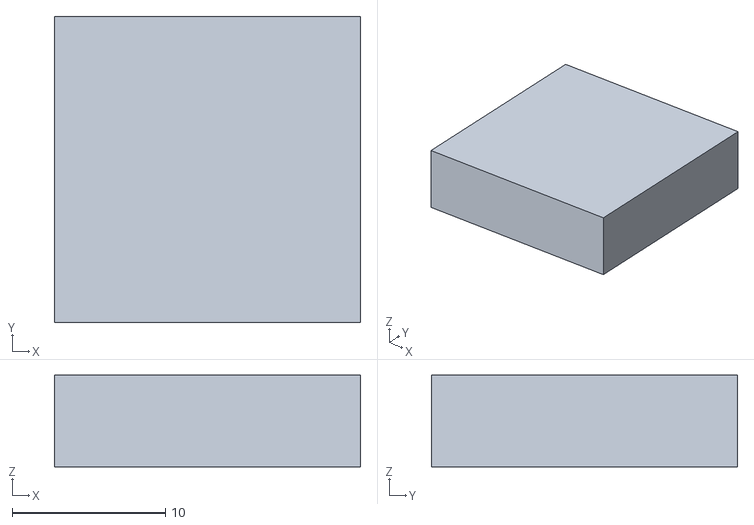
[picture p28: CAD file, 2026-10-29]
sim/model/export/upper_gps.stl
20.0 x 20.0 x 6.00
