DKen-DevCat/matrix-rc/sim/model/export/lower_pins.stl

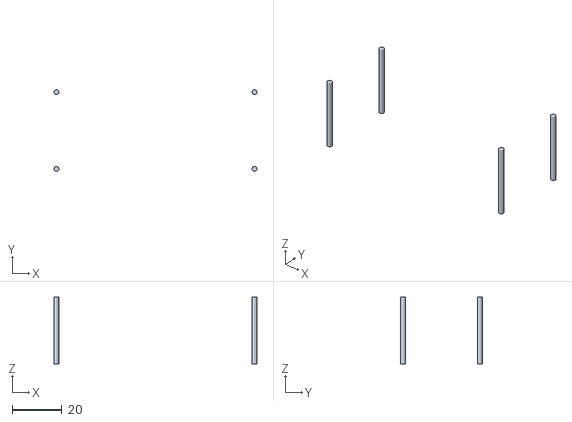
[picture p29: CAD file, 2026-10-29]
sim/model/export/lower_pins.stl
82.0 x 33.0 x 27.0
