DKen-DevCat/matrix-rc/sim/model/export/lower_cam.stl

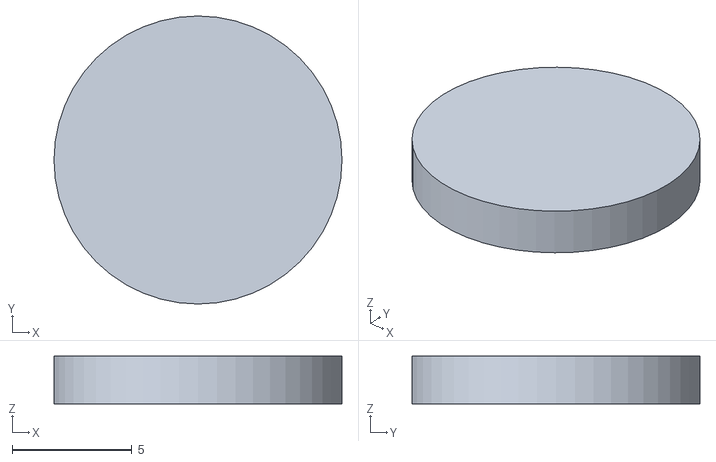
[picture p30: CAD file, 2026-10-29]
sim/model/export/lower_cam.stl
12.0 x 12.0 x 2.00
