DKen-DevCat/matrix-rc/sim/model/export/upper_switch.stl

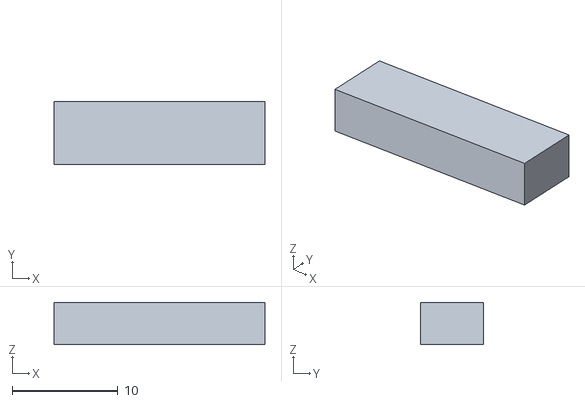
[picture p31: CAD file, 2026-10-29]
sim/model/export/upper_switch.stl
20.0 x 6.00 x 4.00
