DKen-DevCat/matrix-rc/sim/model/export/upper_plate.stl

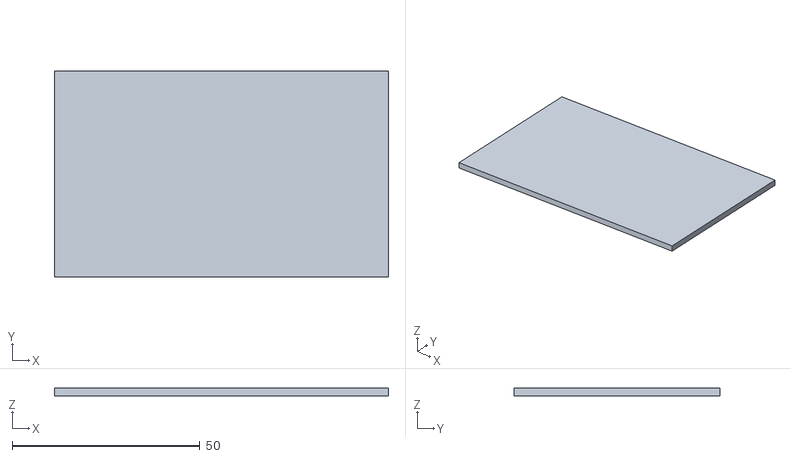
[picture p32: CAD file, 2026-10-29]
sim/model/export/upper_plate.stl
89.0 x 55.0 x 2.00
