DKen-DevCat/matrix-rc/sim/model/export/lower_jump_can.stl

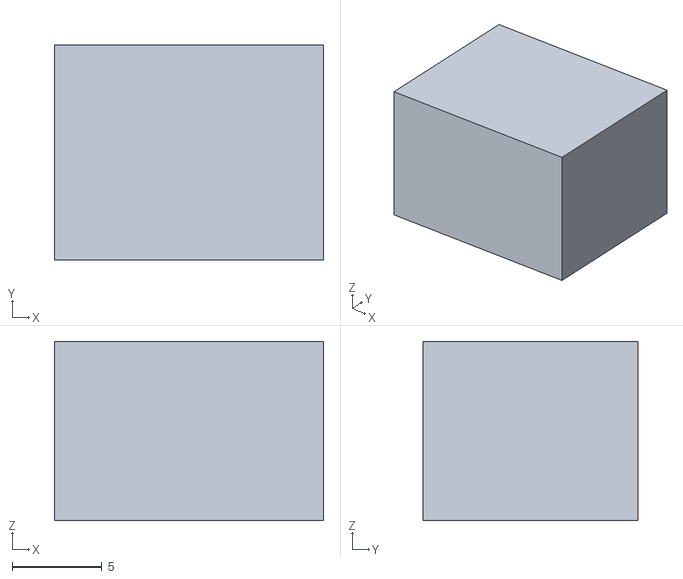
[picture p33: CAD file, 2026-10-29]
sim/model/export/lower_jump_can.stl
15.0 x 12.0 x 10.0
