DKen-DevCat/matrix-rc/sim/model/export/lower_jump_gear.stl

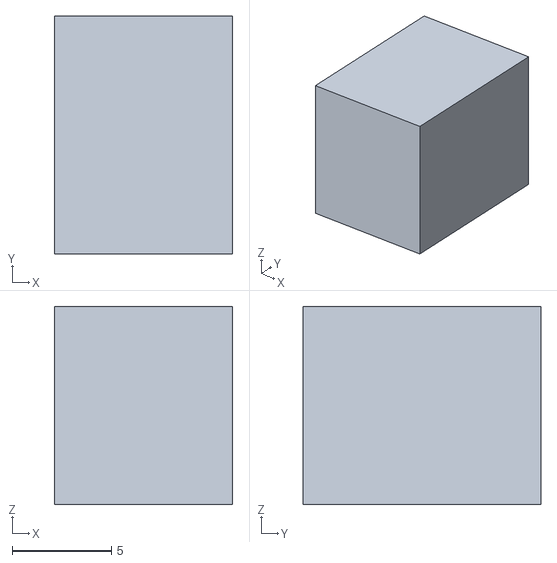
[picture p34: CAD file, 2026-10-29]
sim/model/export/lower_jump_gear.stl
9.00 x 12.0 x 10.0
