DKen-DevCat/matrix-rc/sim/model/export/upper_driver.stl

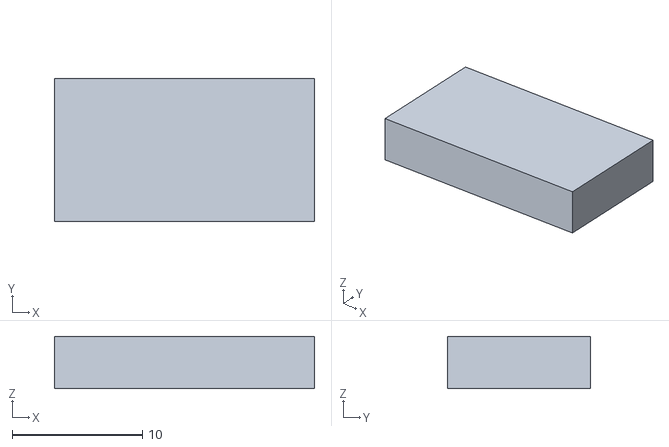
[picture p35: CAD file, 2026-10-29]
sim/model/export/upper_driver.stl
20.0 x 11.0 x 4.00
