DKen-DevCat/matrix-rc/sim/model/export/lower_plate.stl

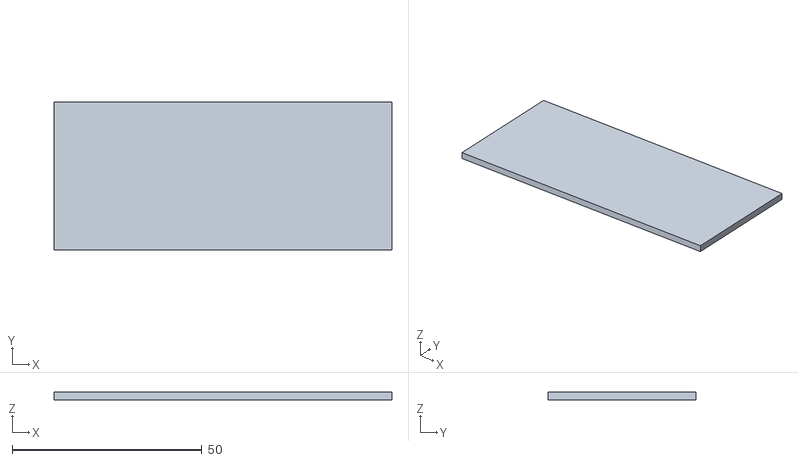
[picture p36: CAD file, 2026-10-29]
sim/model/export/lower_plate.stl
89.0 x 39.0 x 2.00
