DKen-DevCat/matrix-rc/sim/model/export/upper_xiao.stl

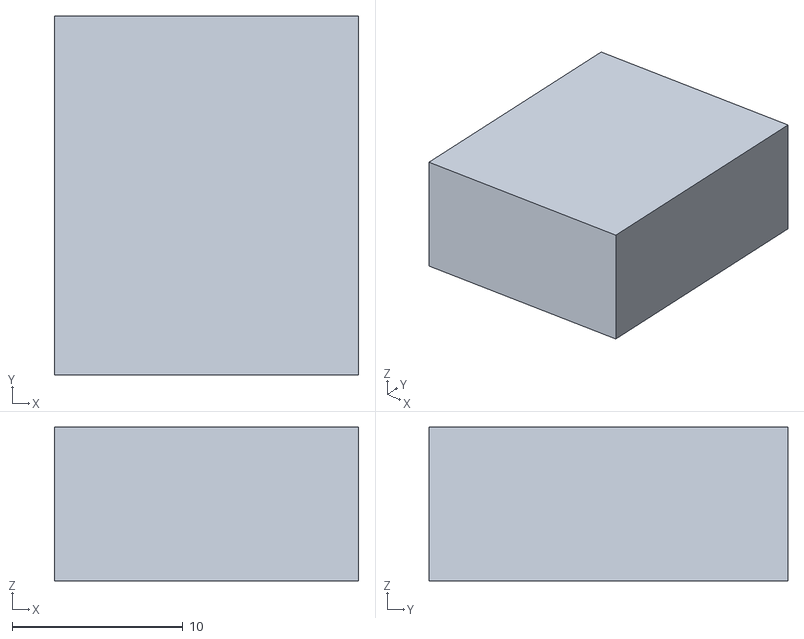
[picture p37: CAD file, 2026-10-29]
sim/model/export/upper_xiao.stl
17.8 x 21.0 x 9.00
