DKen-DevCat/matrix-rc/sim/model/export/lower_springs.stl

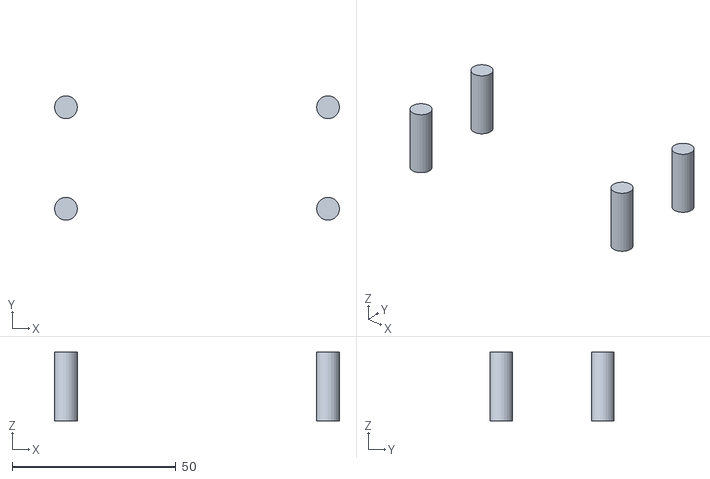
[picture p38: CAD file, 2026-10-29]
sim/model/export/lower_springs.stl
87.0 x 38.0 x 21.0
