DKen-DevCat/matrix-rc/(list of files, cad)

Other CAD files:
sim/fusion/sample/wheel_rr.stl
sim/model/export/lower_motor_r_can.stl
sim/model/export/lower_motor_r_gear.stl
sim/fusion/sample/wheel_fr.stl
sim/model/export/wheel_rr.stl
sim/fusion/sample/wheel_fl.stl
sim/model/export/wheel_rl.stl
sim/model/export/wheel_fl.stl
sim/model/export/wheel_fr.stl
