DKen-DevCat/matrix-rc/docs/sim/step_sweep.csv

tilt_deg | motor | speed_mps | trigger_mm | successes | trials
0 | Pololu136 | 0.517 | 0 | 0 | 10
0 | Pololu136 | 0.517 | 5 | 0 | 10
0 | Pololu136 | 0.517 | 10 | 2 | 10
0 | Pololu136 | 0.517 | 15 | 5 | 10
0 | Pololu136 | 0.517 | 20 | 7 | 10
0 | Pololu136 | 0.517 | 25 | 10 | 10
0 | Pololu136 | 0.517 | 30 | 10 | 10
0 | Pololu136 | 0.517 | 35 | 10 | 10
0 | Pololu136 | 0.517 | 40 | 10 | 10
0 | Pololu136 | 0.517 | 45 | 9 | 10
0 | Pololu136 | 0.517 | 50 | 6 | 10
0 | Pololu136 | 0.517 | 55 | 5 | 10
0 | Pololu136 | 0.517 | 60 | 1 | 10
0 | 300rpm | 0.248 | 0 | 0 | 10
0 | 300rpm | 0.248 | 5 | 1 | 10
0 | 300rpm | 0.248 | 10 | 1 | 10
0 | 300rpm | 0.248 | 15 | 0 | 10
0 | 300rpm | 0.248 | 20 | 0 | 10
0 | 300rpm | 0.248 | 25 | 0 | 10
0 | 300rpm | 0.248 | 30 | 0 | 10
0 | 300rpm | 0.248 | 35 | 0 | 10
0 | 300rpm | 0.248 | 40 | 0 | 10
0 | 300rpm | 0.248 | 45 | 0 | 10
0 | 300rpm | 0.248 | 50 | 0 | 10
0 | 300rpm | 0.248 | 55 | 0 | 10
0 | 300rpm | 0.248 | 60 | 0 | 10
0 | 500rpm | 0.413 | 0 | 0 | 10
0 | 500rpm | 0.413 | 5 | 0 | 10
0 | 500rpm | 0.413 | 10 | 2 | 10
0 | 500rpm | 0.413 | 15 | 5 | 10
0 | 500rpm | 0.413 | 20 | 7 | 10
0 | 500rpm | 0.413 | 25 | 10 | 10
0 | 500rpm | 0.413 | 30 | 10 | 10
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
