DKen-DevCat/matrix-rc/sim/calibration/friction.csv

# 床の摩擦。4 輪とも回らないようにテープで止めた機体を、床と同じ材料の板に載せて少しずつ傾け、
# 滑り始めた角度を記録する（μ = tan θ）。車輪が回ると前輪の分だけ小さく出るので必ず止める
surface,slip_angle_deg
