DKen-DevCat/matrix-rc/sim/calibration/spring.csv

# ばね 1 本の実測。キッチンスケールの上でばねを押し縮め、縮めた量と表示（g）を記録する
compression_mm | force_g
