DKen-DevCat/matrix-rc/(commit log)

2026-10-25 chore: 初期構成 — README（Notion 設計資料へのリンク）・CLAUDE.md・図面10枚と生成スクリプト
2026-10-25 docs: 設計レビュー（2026-10-25）を追加し、図面と README を修正
    - docs/review-2026-10-25.md：計画・設計書①②③・図面のレビューと反映状況
    - 図面：C2 の電池表記を 600〜800mAh 高放電に、C1 の暗号化ラベルを DTLS-PSK にして
    重なりを解消、C3 にカムの収まり未確定の注記、C4 に段差越えの前進距離と
    ばね寸法の注記、W3 のキャスター破線の描画順を修正、「段階③」を Phase 1-b2 に統一
    - render.sh：Linux の Chromium でも動くように。lib.py の死にコードを削除
    - README：Phase 1-a／1-b1／1-b2／1-b3／2 の段階表、レビューへのリンク、DTLS-PSK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
    [d1.py, d2.py, lib.py]
2026-10-25 chore: プロジェクト名とリポジトリ名を matrix-rc に変更
2026-10-25 feat: Phase 1-a のソフト一式 — 通信プロトコル・中継サーバ・操作画面・機体ファームウェアと PC シミュレータ
    - docs/protocol.md：パケットのバイト配置とテストベクタ（JS と C++ で同じベクタを検証）
    - server/：依存なしの中継サーバ（共有トークン認証、操作権は1台1人、操作は補完せず素通し、往復遅延のログ）
    - web/：50Hz でキー状態を送る操作画面（映像・音声・往復遅延・電池・ジャンプ状態、ラグ計測用の時計）
    - firmware/lib/core：受け付け規則と 300ms 停止、モーター配分、渦巻きカムの状態遷移、電池監視（PC でテ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
2026-10-25 docs: Phase 1-a の購入計画と、注文前に決めてほしいことを追加
2026-10-25 fix: Phase 1-a レビューの修正 — WebSocket の取りこぼし・Origin 検査・落ちる入力・接続し直しの競合、計画に LTE 回線の代案
    サーバ
    - ws.js: upgrade の head（ハンドシェイクと同じセグメントに入った最初のフレーム）を捨てていたので処理する
    - ws.js: Origin が付いた接続は操作画面と同じホストからだけ受ける。Sec-WebSocket-Version 13 以外は拒否
    - ws.js: 受け手の例外で中継サーバ全体が落ちないよう、その接続だけを 1011 で閉じる
    - relay.js: テキストメッセージが `null` だと msg.type で例外が出てサーバが落ちていた。物でない JSON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
    [sim_main.cpp]
2026-10-25 docs: 決めてほしいこと 7 を「機体に LTE を載せる」で決定し、進め方を記載
    - 会場側に機器を置けないため (a) 機体で通信させる で決定。(b)(c) は却下理由を残す
    - 「LTE 回線の代わり」の節を「LTE を機体に載せる進め方」に差し替え：
    入手／1-b1（評価ボード＋台車、UART、PPP）／1-b3（自作基板、リフロー、電源、アンテナ、技適の守り方）の段階ごとの難しさと、
    AI が肩代わりできる部分・自分で手を動かす部分の切り分け、ファームウェアの方針（esp_modem の PPP）、UART による帯域の上限、
    代理店への質問一覧、S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
2026-10-25 docs: LTE の入手先を調査し、メカトラックス MicroCat.1U（SIM7672JP・技適取得済み）を 1-b1 の本命に
    - plan-phase1a.md：入手先の候補表を追加（MicroCat.1／1U、LILYGO・TUOPUONE の SIM7670G、Quectel -JP の Mouser/DigiKey、
    加賀デバイス・キャセイの評価キット）。個人が買える技適済み Cat.1 bis は MicroCat.1U だけだった
    - 7 の最初の行動を「代理店への問い合わせ」から「MicroCat.1U の購入」に変更。問い合わせは保険に
    - 1-b1／1-b3 の進め方を MicroCat.1U 前提に書き換え（RP2350B を UART 素通しにする案、1-b3 で自作基板が不要になる見込み）
    - 購入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
2026-10-25 docs: 技術検証枠（設計書④）へのリンクと、FRAME_META（種別 6）の予約を追加
    エキシビションとして、受け側での高画質化（320×240 → 640×480）と、
    動画生成 AI による映像ラグの予測表示を検証する。詳細は Notion の設計書④。
    FRAME_META は各フレームに反映済みの CONTROL seq を載せ、予測の起点と
    表示の遅れの計測に使う。未実装で、v1 の受け側には影響しない。
2026-10-25 docs: FRAME_META の予約を v1 の実装に合わせて補う
    - 共通ヘッダの種別一覧に 6=FRAME_META（予約）を記載し、節と矛盾しないようにする
    - 「v1 の受け側は知らない種別を捨てる」を実装どおりに書き直す。ブラウザは無視するが、
    サーバは TELEMETRY・VIDEO・AUDIO 以外を転送しないので、実装時は機体・サーバ・ブラウザの
    3 か所を変える必要がある
    - まだ CONTROL を採用していないときのセッションID・seq（0）を定義する
    - UDP は順序を保証しないので、到着順ではなくフレーム番号で VIDEO と対応付けることを明記する
    - セッ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
2026-10-27 docs: ジャンプ用 MOSFET・ダイオードを IRLU3410／1N5819 に決定し、W1・W2 を直す
    「決めてほしいこと 4」を (a) で決定。1-a はブレッドボードに挿せるリード部品にする。
    名刺サイズの C2（1-b3）は面実装の AO3400／SS14 のまま。
    Claude-Session: https://claude.ai/code/session_01X43V284hrK6d133yzbzFuZ
2026-10-27 feat: 物理演算による事前検証の環境（sim/、MuJoCo）
    作る前に図面どおり動くかを確かめる環境。寸法の正本は sim/matrix_sim/params.py
    （設計書②・C3・C4 の値。推定値は明記し、1-a の実測で合わせ込む）。
    - 計算：寸法の干渉、カムのトルクとチャージ時間
    - 物理演算：その場ジャンプ、助走付きの段差越え（ばらつき 10 通り）、30cm 落下
    - シミュレーション自体を解析解と比べるテスト（自由落下、ばね質量系、走行速度、
    運動量の上限、時間刻みの収束）
    - docs/sim-report.md に結果の表・CSV・コマ送り画像
    分かったこと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
    [step_sweep.csv]
2026-10-27 fix(sim): ストッパーの硬さ・滞空時間・タイミング幅の計算をレビューに沿って直す
    - lift 関節のストッパーに solreflimit を付ける（既定の 0.02s は接触の 5 倍柔らかく、
    伸びきりを 5.8mm、落下で縮めきりを 4.8mm 越えて上段が下段にめり込んでいた）。
    加速度は 33g→74g（ジャンプ）、50g→184g（落下）、跳ね返りは 137→90mm
    - 滞空は 1 回目の離陸から 1 回目の着地まで（ひっくり返って寝ている時間を数えていた）
    - タイミングの幅は、合格が連続するいちばん長い区間の実測幅（格子 1 刻み分を足さない）
    - report の見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
    [step_sweep.csv]
2026-10-27 feat(sim): Fusion からの書き出しの読み込みと、実測値での合わせ込み
    - sim/fusion/export_for_sim：Fusion のスクリプト。役割付きのコンポーネント
    （upper_*／lower_*／wheel_rl 等）を STL と parts.json（質量・重心・外形）で書き出す
    - matrix_sim/parts.py：書き出しを読み、寸法・質量・車輪の位置を params に移す。
    上段・下段はメッシュ（慣性は MuJoCo がメッシュから計算）、車輪は外形から円柱。
    STL の単位は外形と比べて自動判定
    - fusion/sample：今の箱と円柱のモデルから作った書き出しの見本（make sample）
    - matrix_sim/calibrate.py と cali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
    [friction.csv, lower_deck.stl, motor.csv, spring.csv, upper_deck.stl, wheel_fl.stl, wheel_fr.stl, wheel_rl.stl]
2026-10-27 fix(sim): レビューに沿って Fusion の読み込みと合わせ込みを直す
    - 外形は preciseBoundingBox、質量・重心は高精度で計算する
    - 車輪の中心の高さが半径と合わない書き出しは止める（原点の約束違反）
    - 重心を Fusion の値とメッシュからの計算で比べ、差をレポートに出す
    （密度の違う物を 1 部品にまとめたときに気づけるように）
    - モーターの実測は同じ電圧の行を平均する
    - 床の摩擦は 4 輪を止めて測る（前輪が回ると小さく出る）
    - 見本の STL を外向きの面にそろえる。cm 単位の STL もテストする
    - view に --measured
    Co-Aut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
    [friction.csv, lower_deck.stl, upper_deck.stl, wheel_fl.stl, wheel_fr.stl, wheel_rl.stl, wheel_rr.stl]
2026-10-28 feat(design): 上段を 6mm 上げ、真上跳び＋走行 1000rpm 級に変更（物理演算の指摘への判断）
    物理演算（sim/）の 2 つの指摘への設計判断（2026-10-28）：
    - 縮めた上段がタイヤに 4mm 当たる → 上段を 6mm 上げる（下面 38mm・全高 52mm・すき間 18mm）
    - 真上跳び＋300/500rpm では 30mm 段差を越えられない → 走行モーターを 1000rpm 級 N20 に
    （0.67m/s。段差の 30〜50mm 手前で発射すると 10 回中 8〜10 回。ばね軸は傾けない）
    params・図面 C3/C4/W1・Fusion 書き出しの見本・レポート・1-a 計画を揃え、
    設計判断と「見つかったこと」をテストに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
    [step_sweep.csv, upper_deck.stl]
2026-10-28 feat(model): 機体の 3D モデルを Blender でコードから組み、部品ごとの質量・重心で物理演算する
    Fusion（GUI、この Mac にない）の代わりに sim/model/build_model.py で部品を組む（make model）。
    部品ごとの STL と parts.json（質量・体積重心・外形・密度）を model/export に書き出し、
    既存の parts.py の流れでそのまま物理演算に読ませる。図は docs/model。
    - 質量は設計書② 4 章の重量表を部品に割り振る（合計 110g：上段 62g・下段 48g）
    - make report の既定を 3D モデルに（箱と円柱の近似は make report-box）。結果：
    その場ジャンプ 46mm、採用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
    [lower_axle_f.stl, lower_cam.stl, lower_jump_motor.stl, lower_motor_l.stl, lower_motor_r.stl, lower_pins.stl, lower_plate.stl, step_sweep.csv]
2026-10-29 feat(model): 部品を型番どおりにモデリングし、車輪 φ32・電池 LP603449・ばねを四隅に
    - 車輪を Pololu 32×7mm（φ32、3.2g）に、電池を EEMB LP603449-PCM-LD（34.5×51×6.3mm、約 23g）に
    - φ32 に合わせて上段の板の下面を 44mm に（縮めて 34mm、タイヤ上端 32mm に 2mm の余裕）
    - 電池（幅 34.5）が旧位置のばねと重なるので、ばねとガイドピンを四隅（x 6/86、y ±15.5）に
    - N20 は缶とギアボックスに分け、軸を車輪の中心に合わせる。カム位置スイッチ（SS-10GL13）を追加
    - PARTS 表に部品ごとの出典（メーカー値か推定）を書き、parts.json にも出す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
    [lower_axle_f.stl, lower_cam.stl, lower_cam_switch.stl, lower_deck.stl, lower_jump_can.stl, lower_jump_gear.stl, lower_jump_motor.stl, lower_motor_l.stl]
2026-10-29 feat(drive): 走行モーターを Pololu 136:1 6mm 遊星にして左右を一直線に並べ、後輪を揃える
    後輪を前後にずらすと、段差の角に当たる時刻が左右でずれ、越えたあと向きが平均 6°・最大 33° 変わる
    （平らな床では 1〜2°）。N20（24mm）は 2 個並べると 48mm で車輪の内側（41mm）に入らないので、
    長さ 19mm・1.25g の Pololu 136:1（6V 500rpm、停動 8oz·in：メーカー値）に替え、後輪を x23 に揃えた。
    - 109.5g、跳躍 41mm（C4 の目標 40mm を回復）、段差は 25〜45mm 手前で 10 回中 9〜10 回、向きの変化 1° 前後
    - 6V 定格を 1S で回すので速度の上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
    [lower_motor_l_can.stl, lower_motor_l_gear.stl, lower_motor_r_can.stl, lower_motor_r_gear.stl, step_sweep.csv, wheel_rl.stl, wheel_rr.stl]
